johanjoensson/Komborobot/Dokumentation/Teknisk_Dokumentation/appendix.tex

%% --------------------------------------------------------------------------------------------------------------------------------------------
% APPENDIX - Blindtarm
%
% --matja307, 2012-05-06
%% --------------------------------------------------------------------------------------------------------------------------------------------

\appendix
\section{Appendix}

\lstset{inputencoding=utf8,
        language=c,
        linewidth=\textwidth,
        basicstyle=\scriptsize,
        numbers=left,
        stepnumber=1,
        tabsize=8,
        showtabs=false
}
\lstset{literate={å}{{\aa}}1
                {ä}{{\"a}}1
                {ö}{{\"o}}1
                {Å}{{\AA}}1
                {Ä}{{\"A}}1
                {Ö}{{\"O}}1
}

\subsection{Omvandlingsdiagram}
\label{appendix:cmomvandling}

\begin{figure}[H]
  \centering
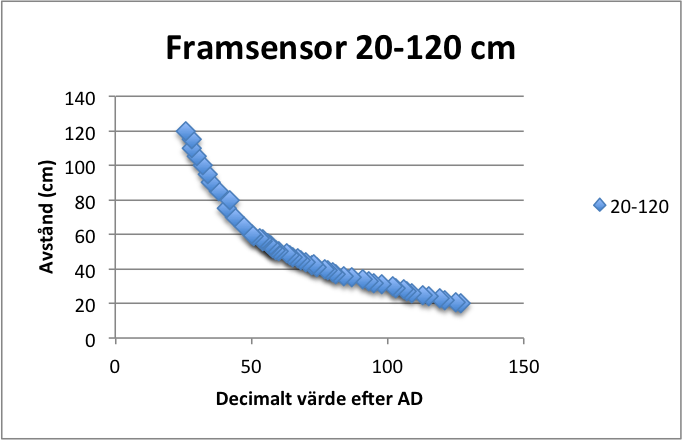
[picture p1: Dokumentation/Teknisk_Dokumentation/bilder/F_20_120.png]
 
  \caption{Framsensorn omvandling 20-120}
\end{figure}

\begin{figure}[H]
  \centering
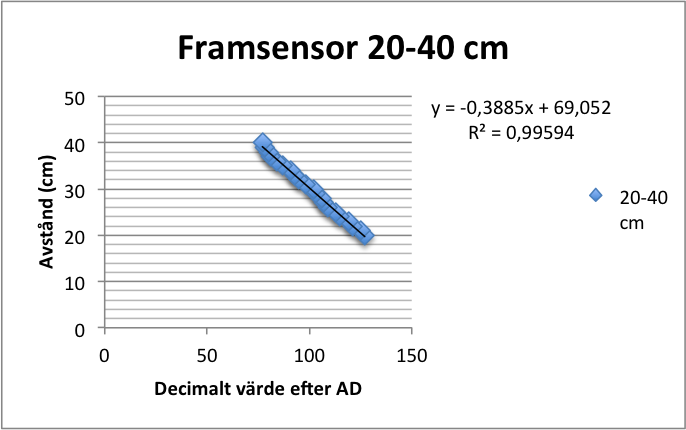
[picture p2: Dokumentation/Teknisk_Dokumentation/bilder/F_20_40.png]
 
  \caption{Framsensorn omvandling 20-40}
\end{figure}

\begin{figure}[H]
  \centering
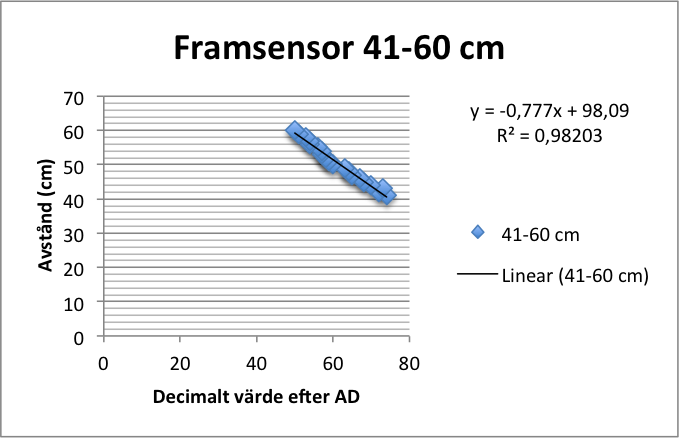
[picture p3: Dokumentation/Teknisk_Dokumentation/bilder/F_41_60.png]
 
  \caption{Framsensorns omvandling 41-60}
\end{figure}

\begin{figure}[H]
  \centering
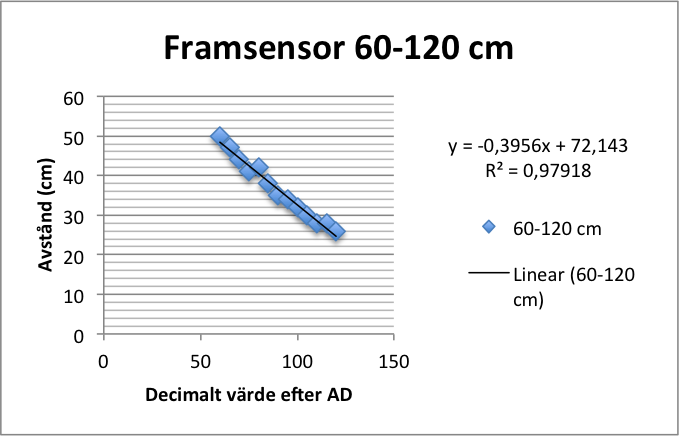
[picture p4: Dokumentation/Teknisk_Dokumentation/bilder/F_60_120.png]
 
  \caption{Framsensorn omvandling 60-120}
\end{figure}

\begin{figure}[H]
  \centering
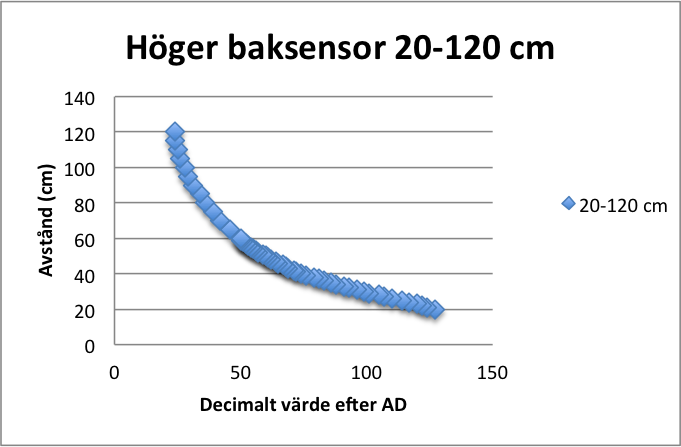
[picture p5: Dokumentation/Teknisk_Dokumentation/bilder/HB_20_120.png]
 
  \caption{Höger baksensor 20-120}
\end{figure}

\begin{figure}[H]
  \centering
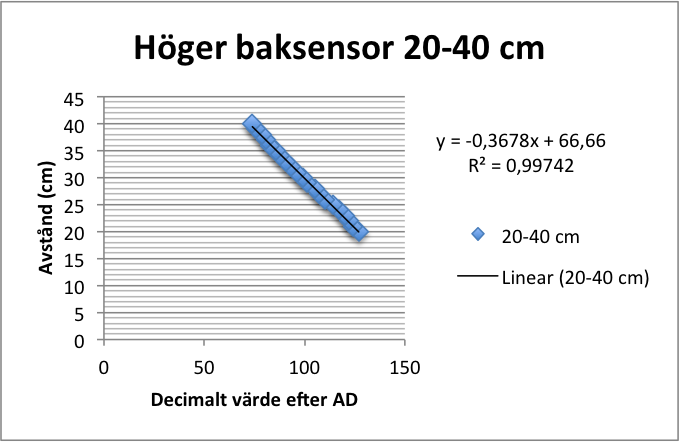
[picture p6: Dokumentation/Teknisk_Dokumentation/bilder/HB_20_40.png]
 
  \caption{Höger baksensor 20-40}
\end{figure}

\begin{figure}[H]
  \centering
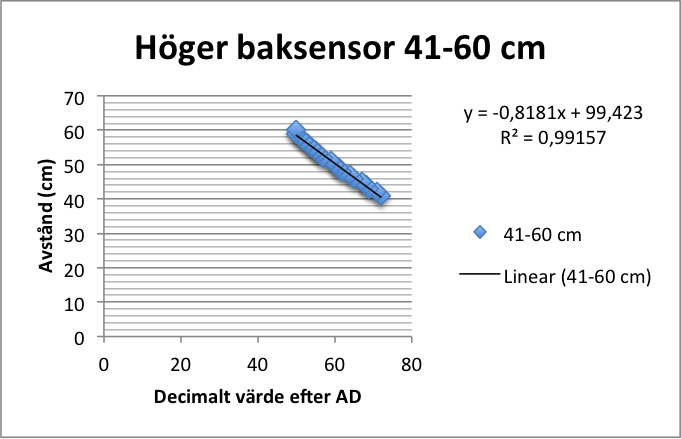
[picture p7: Dokumentation/Teknisk_Dokumentation/bilder/HB_41_60.png]
 
  \caption{Höger baksensor 41-60}
\end{figure}

\begin{figure}[H]
  \centering
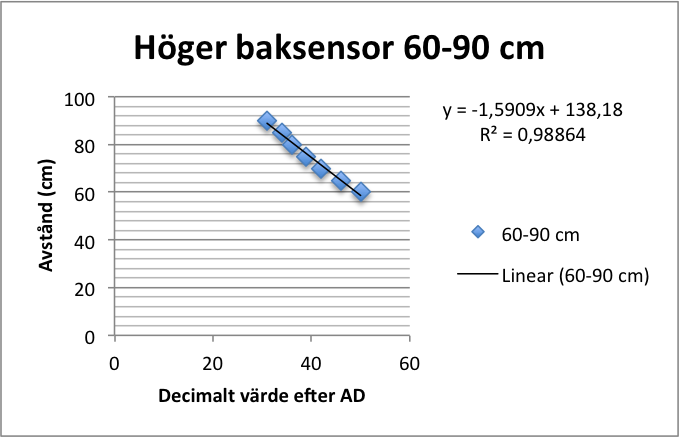
[picture p8: Dokumentation/Teknisk_Dokumentation/bilder/HB_60_90.png]
 
  \caption{Höger baksensor 60-90}
\end{figure}

\begin{figure}[H]
  \centering
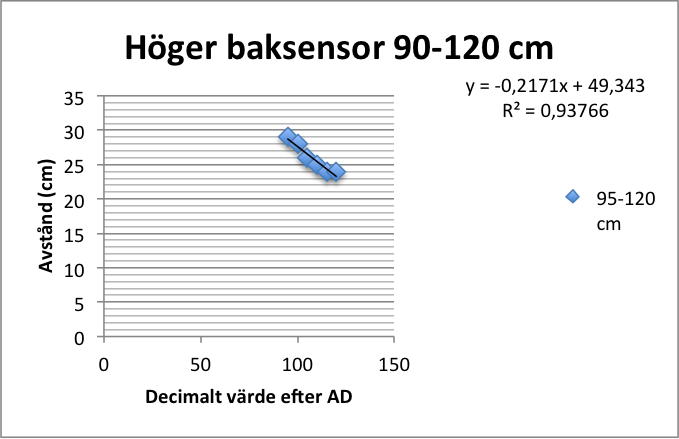
[picture p9: Dokumentation/Teknisk_Dokumentation/bilder/HB_90_120.png]
 
  \caption{Höger baksensor 90-120}
\end{figure}

\begin{figure}[H]
  \centering
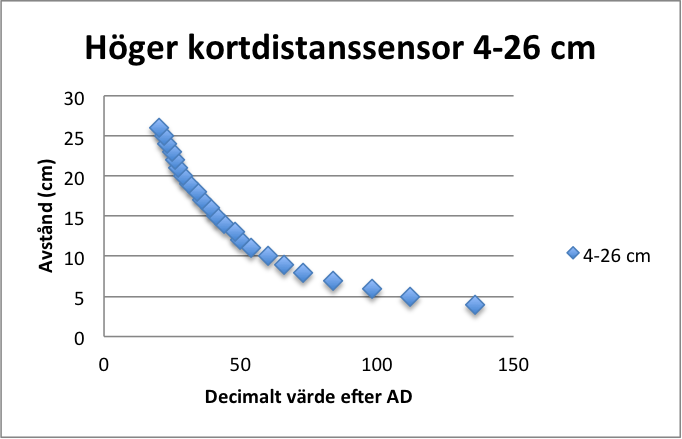
[picture p10: Dokumentation/Teknisk_Dokumentation/bilder/H_K_4_26.png]
 
  \caption{Höger kortdistanssensor 4-26}
\end{figure}

\begin{figure}[H]
  \centering
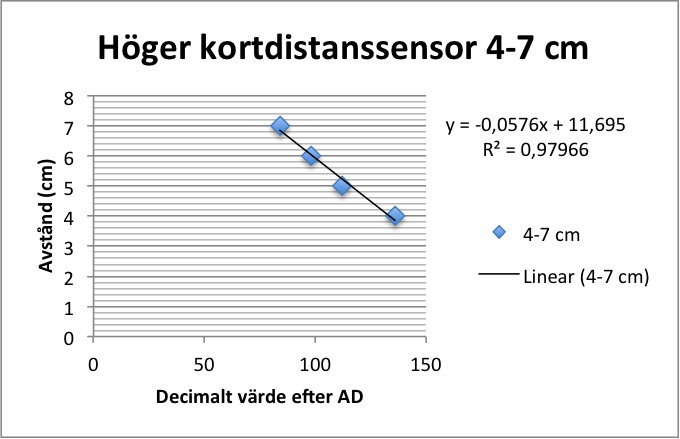
[picture p11: Dokumentation/Teknisk_Dokumentation/bilder/H_K_4_7png.png]
 
  \caption{Höger kortdistanssensor 4-7}
\end{figure}

\begin{figure}[H]
  \centering
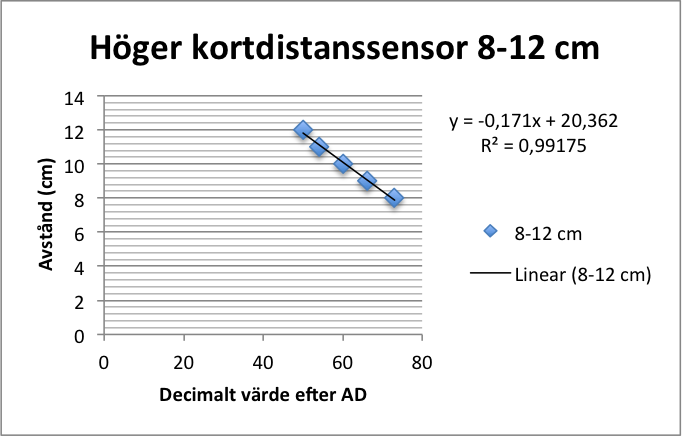
[picture p12: Dokumentation/Teknisk_Dokumentation/bilder/H_K_8_12.png]
 
  \caption{Höger kortdistanssensor 8-12}
\end{figure}

\begin{figure}[H]
  \centering
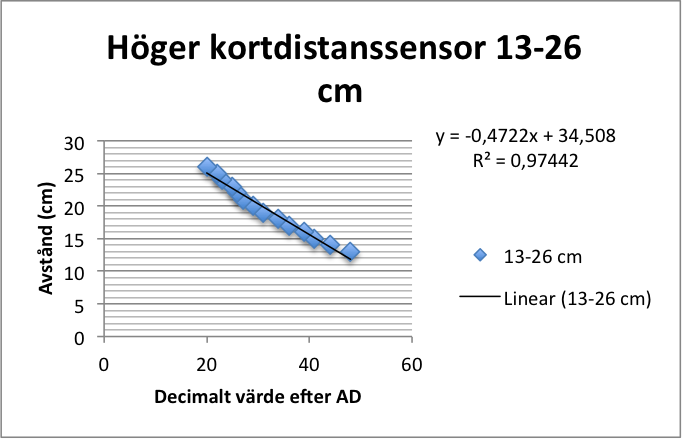
[picture p13: Dokumentation/Teknisk_Dokumentation/bilder/H_K_13_26.png]
 
  \caption{Höger kortdistanssensor 13-26}
\end{figure}

\begin{figure}[H]
  \centering
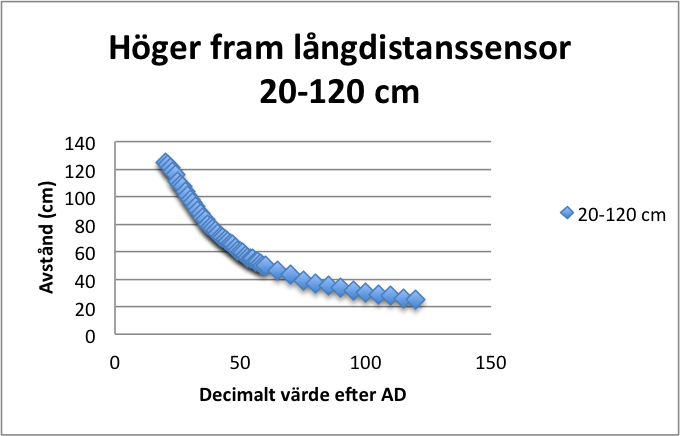
[picture p14: Dokumentation/Teknisk_Dokumentation/bilder/HF_20_120.png]
 
  \caption{Höger framsensor 20-120}
\end{figure}

\begin{figure}[H]
  \centering
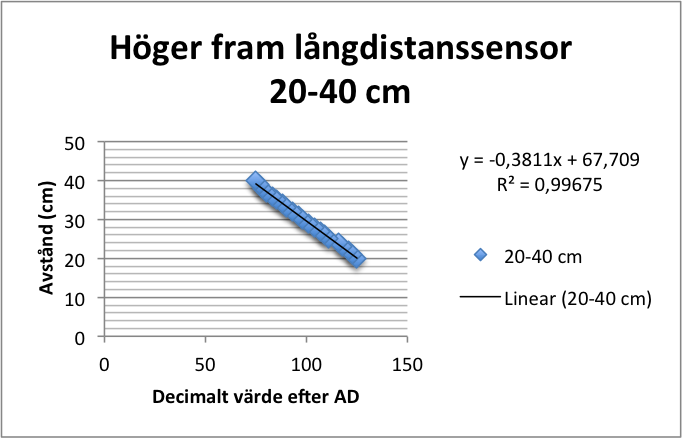
[picture p15: Dokumentation/Teknisk_Dokumentation/bilder/HF_20_40.png]
 
  \caption{Höger framsensor 20-40}
\end{figure}

\begin{figure}[H]
  \centering
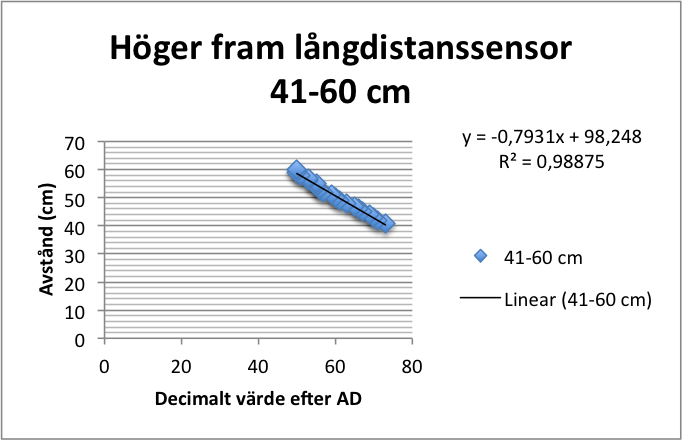
[picture p16: Dokumentation/Teknisk_Dokumentation/bilder/HF_41_60.png]
 
  \caption{Höger framsensor 41-60}
\end{figure}

\begin{figure}[H]
  \centering
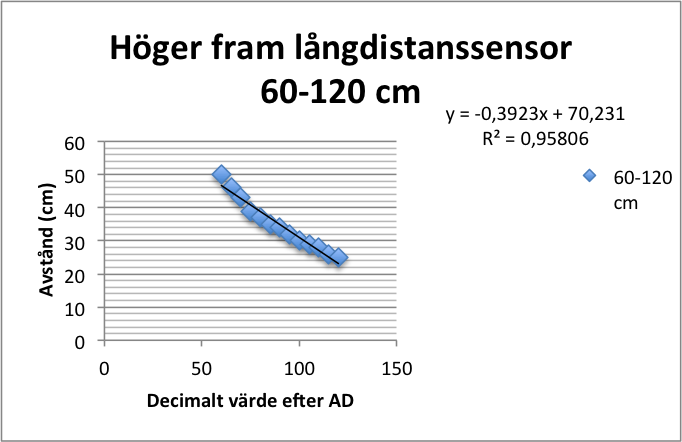
[picture p17: Dokumentation/Teknisk_Dokumentation/bilder/HF_60_120.png]
 
  \caption{Höger framsensor 60-120}
\end{figure}

\begin{figure}[H]
  \centering
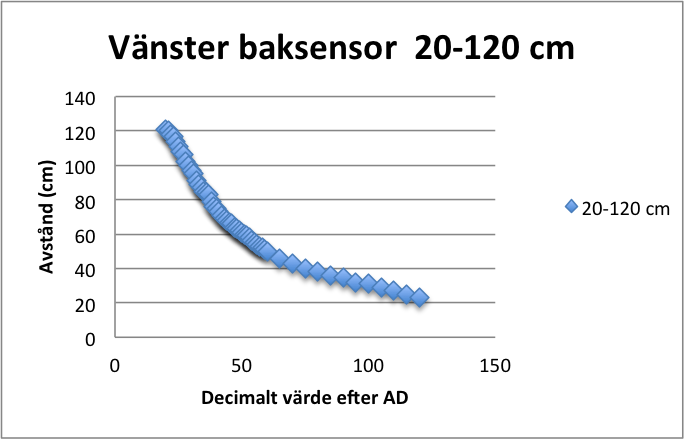
[picture p18: Dokumentation/Teknisk_Dokumentation/bilder/VB_20_120.png]
 
  \caption{Vänster baksensor 20-120}
\end{figure}

\begin{figure}[H]
  \centering
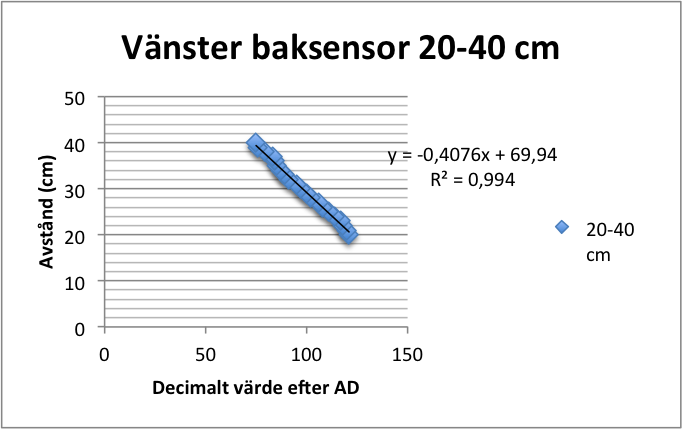
[picture p19: Dokumentation/Teknisk_Dokumentation/bilder/VB_20_40.png]
 
  \caption{Vänster baksensor 20-40}
\end{figure}

\begin{figure}[H]
  \centering
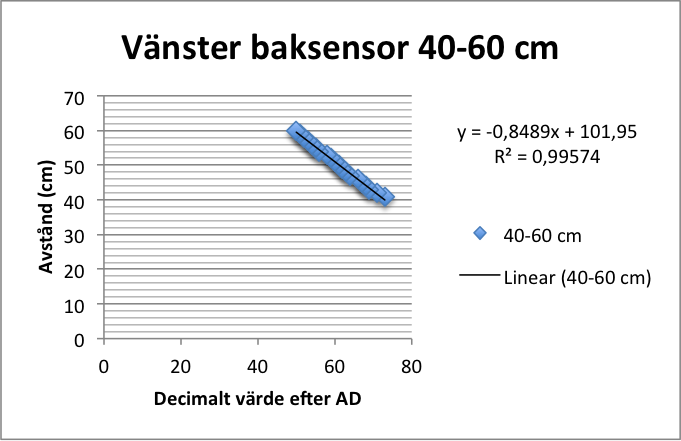
[picture p20: Dokumentation/Teknisk_Dokumentation/bilder/VB_40_60.png]
 
  \caption{Vänster baksensor 40-60}
\end{figure}

\begin{figure}[H]
  \centering
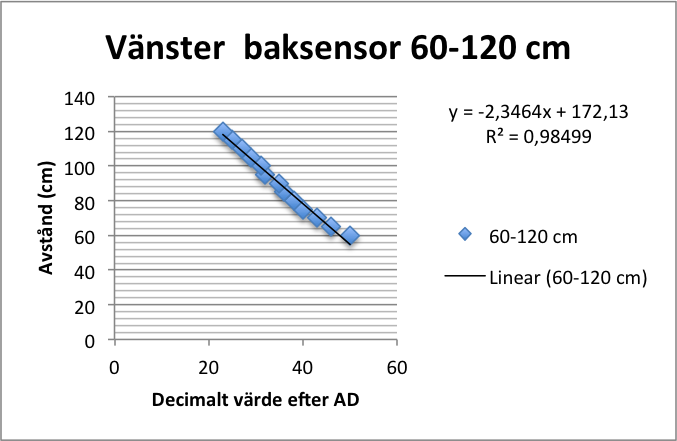
[picture p21: Dokumentation/Teknisk_Dokumentation/bilder/VB_60_120.png]
 
  \caption{Vänster baksensor 60-120}
\end{figure}

\begin{figure}[H]
  \centering
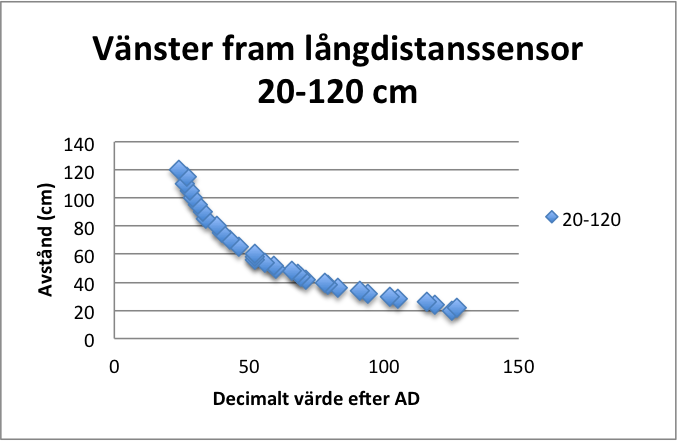
[picture p22: Dokumentation/Teknisk_Dokumentation/bilder/VF_20_120.png]
 
  \caption{Vänster framsensor 20-120}
\end{figure}

\begin{figure}[H]
  \centering
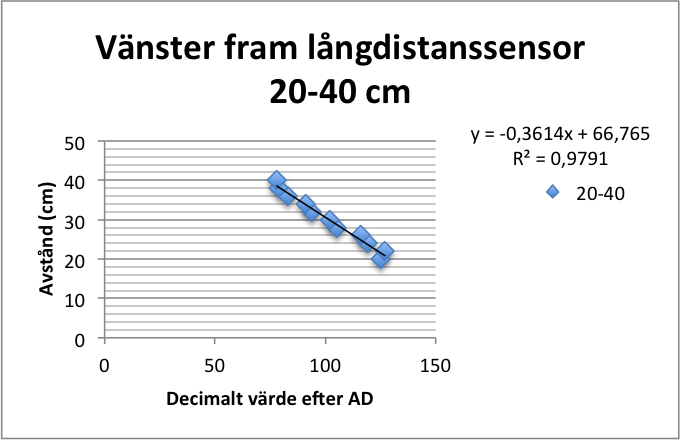
[picture p23: Dokumentation/Teknisk_Dokumentation/bilder/VF_20_40.png]
 
  \caption{Vänster framsensor 20-40}
\end{figure}

\begin{figure}[H]
  \centering
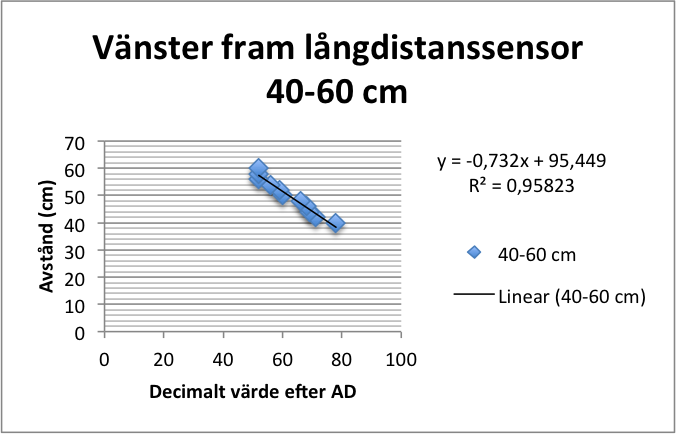
[picture p24: Dokumentation/Teknisk_Dokumentation/bilder/VF_40_60.png]
 
  \caption{Vänster framsensor 40-60}
\end{figure}

\begin{figure}[H]
  \centering
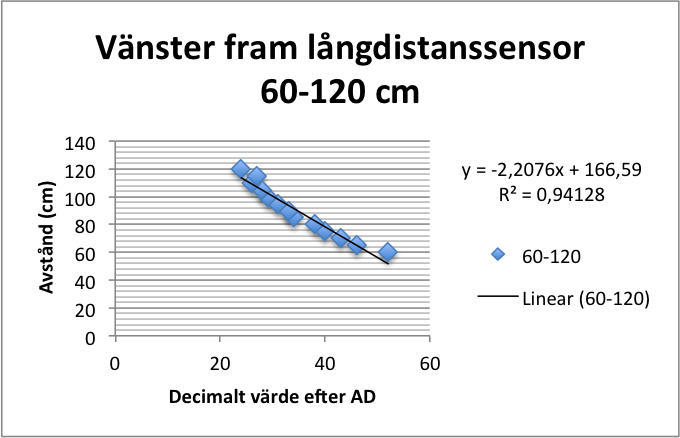
[picture p25: Dokumentation/Teknisk_Dokumentation/bilder/VF_60_120.png]
 
  \caption{Vänster framsensor 60-120}
\end{figure}

\subsection{Kod}
%\addcontentsline{toc}{subsection}{B \hspace*{1em} Kod}

%%%%%%%%%%%%%%%%%%%%%%%%%%%%%%%%%%%%%%%%%%%%%%%%%%%%%%%%%%%%%%%%%%%%%%%%%%%%%%%
% PC
% Kod till användargränssnittet
%%%%%%%%%%%%%%%%%%%%%%%%%%%%%%%%%%%%%%%%%%%%%%%%%%%%%%%%%%%%%%%%%%%%%%%%%%%%%%%
\subsubsection{PC}
\lstinputlisting[caption=input\_control,label=lst:input]{../../Kod/pc/input_control.c}
\lstinputlisting[caption=keypress.h,label=lst:keypress_h]{../../Kod/pc/keypress.h}
\lstinputlisting[caption=keypress.c,label=lst:keypress_c]{../../Kod/pc/keypress.c}
\lstinputlisting[caption=header.h,label=lst:header_h]{../../Kod/pc/header.h}
\lstinputlisting[caption=header.c,label=lst:header_c]{../../Kod/pc/header.c}
\lstinputlisting[caption=send\_receive.c,label=lst:sendrec_c]{../../Kod/pc/send_receive.c}
\lstinputlisting[caption=blue\_pc.h,label=lst:blue_h]{../../Kod/pc/blue_pc.h}
\lstinputlisting[caption=blue\_pc.c,label=lst:blue_c]{../../Kod/pc/blue_pc.c}
\lstinputlisting[caption=db.h,label=lst:db_h]{../../Kod/pc/db.h}
\lstinputlisting[caption=db.c,label=lst:db_c]{../../Kod/pc/db.c}
\lstinputlisting[caption=display.h,label=lst:display_h]{../../Kod/pc/display.h}
\lstinputlisting[caption=display.c,label=lst:display_c]{../../Kod/pc/display.c}

%%%%%%%%%%%%%%%%%%%%%%%%%%%%%%%%%%%%%%%%%%%%%%%%%%%%%%%%%%%%%%%%%%%%%%%%%%%%%%%
% Kommunikationsenhet
%%%%%%%%%%%%%%%%%%%%%%%%%%%%%%%%%%%%%%%%%%%%%%%%%%%%%%%%%%%%%%%%%%%%%%%%%%%%%%%
\newpage
\subsubsection{Kommunikationsenhet}
\lstinputlisting[caption=komm\_main.c,label=lst:komm_main_c]{../../Kod/komm/komm_main.c}
\lstinputlisting[caption=komm\_init.c,label=lst:komm_init_c]{../../Kod/komm/komm_init.c}
\lstinputlisting[caption=bluetooth\_interrupt.c,%
label=lst:bluetooth_interrupt_c]{../../Kod/komm/bluetooth_interrupt.c}
\lstinputlisting[caption=komm\_SPI.c,label=lst:komm_SPI_c]{../../Kod/komm/komm_SPI.c}

%%%%%%%%%%%%%%%%%%%%%%%%%%%%%%%%%%%%%%%%%%%%%%%%%%%%%%%%%%%%%%%%%%%%%%%%%%%%%%%
% Styrenehet
%%%%%%%%%%%%%%%%%%%%%%%%%%%%%%%%%%%%%%%%%%%%%%%%%%%%%%%%%%%%%%%%%%%%%%%%%%%%%%%
\newpage
\subsubsection{Styrenhet}
\lstinputlisting[caption=styr\_main.c,label=lst:styr_main_c]{../../Kod/styr/styr_main.c}
\lstinputlisting[caption=motor\_styrning.h,label=lst:motor_styrning_h]{../../Kod/styr/motor_styrning.h}
\lstinputlisting[caption=motor\_styrning.c,label=lst:motor_styrning_c]{../../Kod/styr/motor_styrning.c}
\lstinputlisting[caption=regulator.h,label=lst:regulator_h]{../../Kod/styr/regulator.h}
\lstinputlisting[caption=regulator.c,label=lst:regulator_c]{../../Kod/styr/regulator.c}
\lstinputlisting[caption=styr\_specialkommando.h,label=lst:styr_specialkommando_h]{../../Kod/styr/styr_specialkommando.h}
\lstinputlisting[caption=styr\_specialkommando.c,label=lst:styr_specialkommando_c]{../../Kod/styr/styr_specialkommando.c}
\lstinputlisting[caption=styr\_tolka\_data.h,label=lst:styr_tolka_data_h]{../../Kod/styr/styr_tolka_data.h}
\lstinputlisting[caption=styr\_tolka\_data.c,label=lst:styr_tolka_data_c]{../../Kod/styr/styr_tolka_data.c}
\lstinputlisting[caption=styr\_SPI.h,label=lst:styr_SPI_h]{../../Kod/styr/styr_SPI.h}
\lstinputlisting[caption=styr\_SPI.c,label=lst:styr_SPI_c]{../../Kod/styr/styr_SPI.c}

%%%%%%%%%%%%%%%%%%%%%%%%%%%%%%%%%%%%%%%%%%%%%%%%%%%%%%%%%%%%%%%%%%%%%%%%%%%%%%%
% Sensorenhet
%%%%%%%%%%%%%%%%%%%%%%%%%%%%%%%%%%%%%%%%%%%%%%%%%%%%%%%%%%%%%%%%%%%%%%%%%%%%%%%
\newpage
\subsubsection{Sensorenhet}
\lstinputlisting[caption=sensor.c,label=lst:sensor_c]{../../Kod/sensor/sensor.c}
\lstinputlisting[caption=sensor\_init.h,label=lst:sensor_init_h]{../../Kod/sensor/sensor_init.h}
\lstinputlisting[caption=sensor\_init.c,label=lst:sensor_init_c]{../../Kod/sensor/sensor_init.c}
\lstinputlisting[caption=sensor\_ad.h,label=lst:sensor_ad_h]{../../Kod/sensor/sensor_ad.h}
\lstinputlisting[caption=sensor\_ad.c,label=lst:sensor_ad_c]{../../Kod/sensor/sensor_ad.c}
\lstinputlisting[caption=sensorvarde\_omvandling.h,label=lst:sensorvarde_omvandling_h]{../../Kod/sensor/sensorvarde_omvandling.h}
\lstinputlisting[caption=sensorvarde\_omvandling.c,label=lst:sensorvarde_omvandling_c]{../../Kod/sensor/sensorvarde_omvandling.c}
\lstinputlisting[caption=displayenhet.h,label=lst:displayenhet_h]{../../Kod/sensor/displayenhet.h}
\lstinputlisting[caption=displayenhet.c,label=lst:displayenhet_c]{../../Kod/sensor/displayenhet.c}
\lstinputlisting[caption=linjeskillnad.h,label=lst:linjeskillnad_h]{../../Kod/sensor/linjeskillnad.h}
\lstinputlisting[caption=linjeskillnad.c,label=lst:linjeskillnad_c]{../../Kod/sensor/linjeskillnad.c}
\lstinputlisting[caption=upptack\_tejp.h,label=lst:upptack_tejp_h]{../../Kod/sensor/upptack_tejp.h}
\lstinputlisting[caption=upptack\_tejp.c,label=lst:upptack_tejp_c]{../../Kod/sensor/upptack_tejp.c}
\lstinputlisting[caption=special.h,label=lst:special_h]{../../Kod/sensor/special.h}
\lstinputlisting[caption=special.c,label=lst:special_c]{../../Kod/sensor/special.c}
\lstinputlisting[caption=sensor\_spi.h,label=lst:sensor_spi_h]{../../Kod/sensor/sensor_spi.h}
\lstinputlisting[caption=sensor\_spi.c,label=lst:sensor_spi_c]{../../Kod/sensor/sensor_spi.c}

\subsection{Kopplingsschema}
\begin{figure}[H]
 \centering
 
  \caption{Kopplingsschema för systemet}
\end{figure}

\subsection{Materiallista}
\input{material.tex}
