johanjoensson/Komborobot/Dokumentation/Teknisk_Dokumentation/other/appendix.tex

\newpage
\appendix

\lstset{language=c}
\lstset{linewidth=\textwidth}

\section{Kopplingsschema sensormodul}
\label{sensor-sch}
  \begin{figure}[ht!]
    \centering
      
      \begin{tabular}{| l | l |}
        \hline
        \textbf{Pin} & \textbf{Funktion} \\ \hline
        JP1.1 & 5 V drivspänning \\ \hline
        JP1.2 & Jord \\ \hline
        JP1.3 & 5 V för ADC:n \\ \hline
        JP1.4 & 5 V referensspänning \\ \hline
        JP1.5 & Klocka (Kristalloscilator) \\ \hline
        JP1.6 & Hård reset \\ \hline
        JP2.1 & Avståndssensor \\ \hline
        JP2.2 & Avståndssensor \\ \hline
        JP2.3 & Avståndssensor \\ \hline
        JP3.1 & Hjulsensor \\ \hline
        JP3.2 & Hjulsensor \\ \hline
        JP6.1 & Gyro \\ \hline
        JP8.1 & UART ut \\ \hline
        JP8.2 & UART in \\ \hline
      \end{tabular}
    \end{figure}

\newpage

\section{Kopplingsschema styrmodul}
\label{styr-sch}
  \begin{figure}[ht!]
    \centering
      
      \begin{tabular}{| l | l |}
        \hline
        \textbf{Pin} & \textbf{Funktion} \\ \hline
        JP1.1 & 5 V drivspänning \\ \hline
        JP1.2 & Klocka (Kristalloscilator) \\ \hline
        JP1.3 & 5 V för ADC:n \\ \hline
        JP1.4 & Jord \\ \hline
        JP1.5 & Hård reset \\ \hline
        JP2.1 & Drivhåll för motor \\ \hline
        JP2.2 & Drivhåll för motor \\ \hline
        JP3.1 & UART in \\ \hline
        JP3.2 & UART ut \\ \hline
        JP4.1 & PWM för motor \\ \hline
        JP4.2 & PWM för motor \\ \hline
      \end{tabular}
    \end{figure}
\section{Kod}
\subsection{PC}
\lstinputlisting[caption=input_control,label=lst:input]{../../Kod/pc/input_control.c}
\subsection{Kommunikationsenhet}
\subsection{Styrenhet}
\subsection{Sensorenhet}
