johanjoensson/Komborobot/Dokumentation/Kravspec_fungerande/delsystem2.pdf

Kommunikationsenhet

Styrenhet | Styrenhet
SPI Buss | PC Blåtand
