johanjoensson/Komborobot/Dokumentation/Kravspec/delsystem.pdf

## PC Styrenhet

Kommunikationsenhet

Sensorenhet
Buss

Blåtand
