johanjoensson/Komborobot/Dokumentation/Teknisk_Dokumentation/bilder/kopplingsschema.pdf

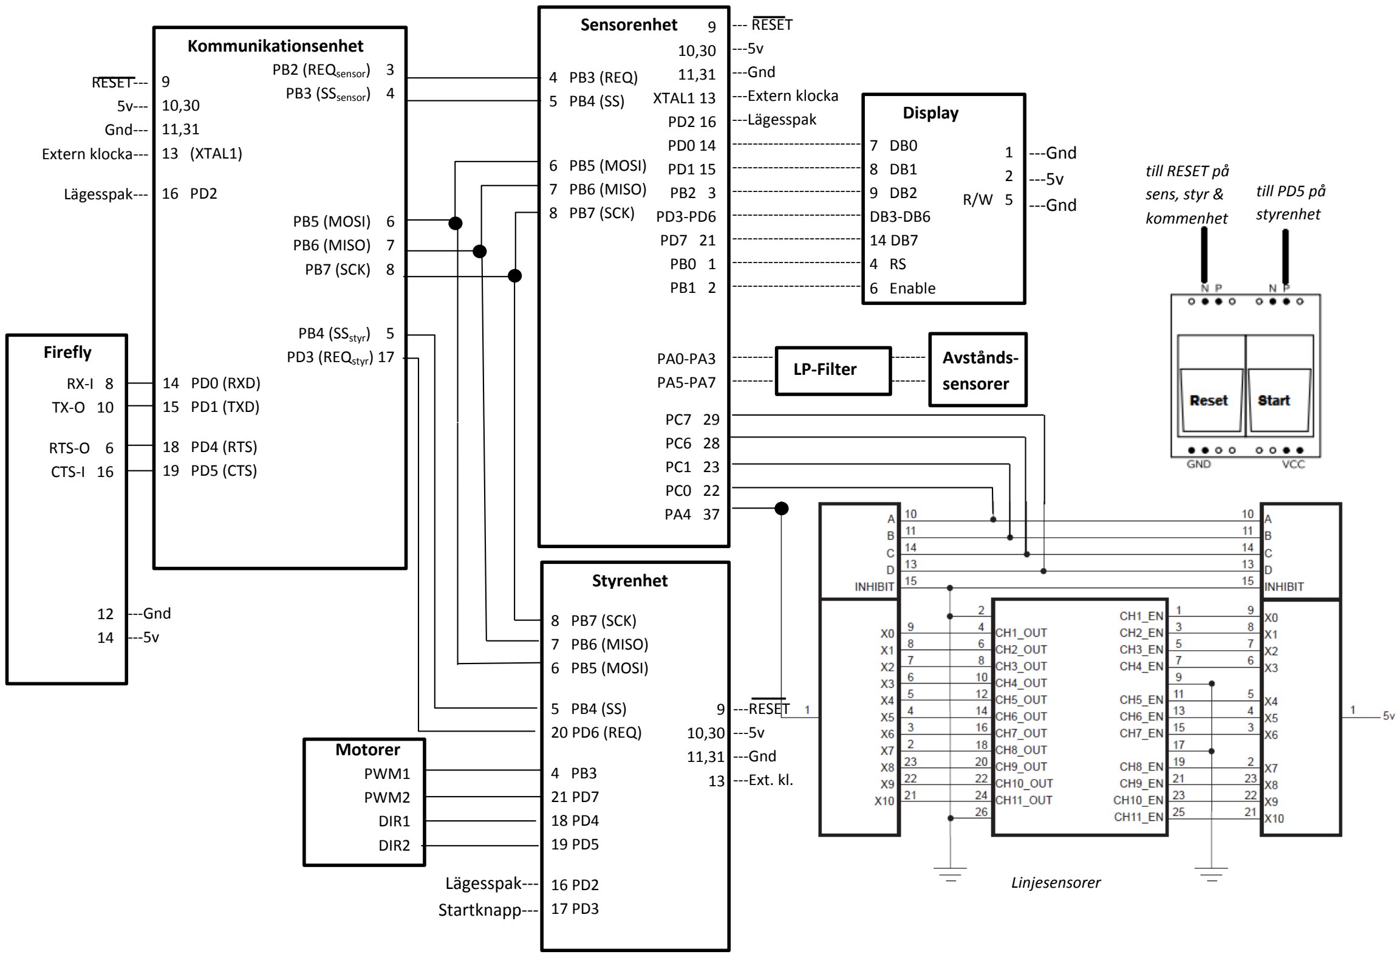
[picture p32: page 1]

Styrenhet

8 PB7 (SCK)
7 PB6 (MISO)
6 PB5 (MOSI)

5 PB4 (SS)
20 PD6 (REQ)

4 PB3
21 PD7
18 PD4
19 PD5

16 PD2
17 PD3

---RESET
---5v
---Gnd
---Ext. kl.

Kommunikationsenhet
PB2 (REQsensor) 3
PB3 (SSsensor) 4

PB5 (MOSI) 6
PB6 (MISO) 7
PB7 (SCK) 8

PB4 (SSstyr) 5
PD3 (REQstyr) 17
14 PD0 (RXD)
15 PD1 (TXD)

18 PD4 (RTS)
19 PD5 (CTS)

Firefly

RX-I 8
TX-O 10

RTS-O 6
CTS-I 16

12
14

9
10,30
11,31
13 (XTAL1)

16 PD2

9
10,30
11,31
XTAL1 13
PD2 16
PD0 14
PD1 15
PB2 3
PD3-PD6
PD7 21
PB0 1
PB1 2

PA0-PA3
PA5-PA7

Sensorenhet

4 PB3 (REQ)
5 PB4 (SS)

6 PB5 (MOSI)
7 PB6 (MISO)
8 PB7 (SCK)

9
10,30
11,31
13

RESET---
5v---
Gnd---
Extern klocka---

Lägesspak---

Linjesensorer

---Gnd
---5v

PC7 29
PC6 28
PC1 23
PC0 22
PA4 37

--- RESET
---5v
---Gnd
---Extern klocka
---Lägesspak

Motorer
PWM1
PWM2
DIR1
DIR2

7 DB0
8 DB1
9 DB2
DB3-DB6
14 DB7
4 RS
6 Enable

Display

1
2
R/W 5

---Gnd
---5v
---Gnd

Lägesspak---
Startknapp---
LP-Filter | Avstånds- sensorer

till RESET på
sens, styr &
kommenhet

till PD5 på
styrenhet
