johanjoensson/Komborobot/Dokumentation/Teknisk_Dokumentation/slutsats.tex

% !TEX encoding = UTF-8 Unicode

%% --------------------------------------------------------------------------------------------------------------------------------------------
% SLUTSATS - Möjliga förbättringar samt utvecklingsmöjligheter
%
% --matja307, 2012-05-06
%% --------------------------------------------------------------------------------------------------------------------------------------------
\section{Slutsats}
Roboten har designats så att den ska kunna vidareutvecklats och byggas på med fler enheter. Några sådana utvecklingsmöjligheter beskrivs nedan. 

\begin{enumerate}[i.]
\item En naturlig utvecklingsmöjlighet är att utöka informationen som visas på PCn. Ett exempel är att visa data även från linjesensorerna. 
Kommunikationsprotpkollet är sådant att det lätt kan utvidgas till att även innefatta denna dataöverföring från sensorenheten till PCn. 
\item Ett annat område som har utvecklingspotential är kalibreringen av linjesensorerna. Detta skulle lämpligen göras en gång för varje enskild sensor, utifrån 
uppmätt istället för inmatad data. 
\item Roboten har designats så att ytterligare funktionalitet vad gäller banans utformning kan läggas till. Exempel på förändringar är att ta bort behovet av riktningsmarkeringar i labyrintläge då de felaktiga vägarna är återvändsgränder av lämplig längd. 
\end{enumerate}
