johanjoensson/Komborobot/Dokumentation/Teknisk_Dokumentation/modulerna.tex

%% --------------------------------------------------------------------------------------------------------------------------------------------
% MODULERNA - Bara inkludering av dokument fšr modulerna.
%
% --matja307, 2012-05-06
%% --------------------------------------------------------------------------------------------------------------------------------------------

\input{komm.tex}
\input{pcmjuk.tex}
\input{sensor.tex}
\input{styr.tex}
