johanjoensson/Komborobot/Dokumentation/Banspecification/Labyrintanvisningar.pdf

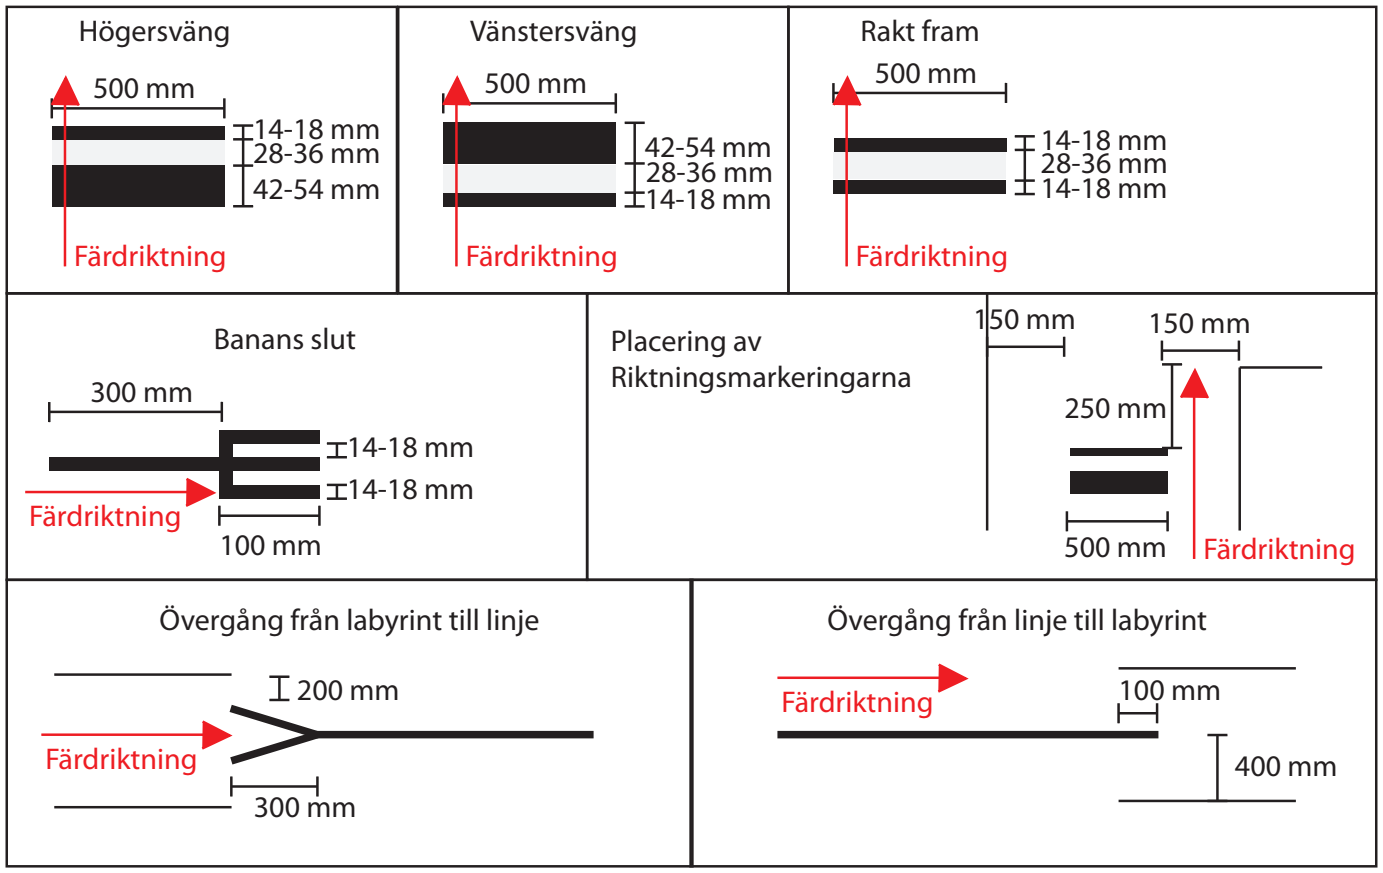
[picture p34: figure]
Högersväng; Banans slut; Färdriktning; Vänstersväng; Rakt fram; Placering av Riktningsmarkeringarna; Övergång från labyrint till linje; Övergång från linje till labyrint
