johanjoensson/Komborobot/Dokumentation/Projektplan/organisation-figur.pdf

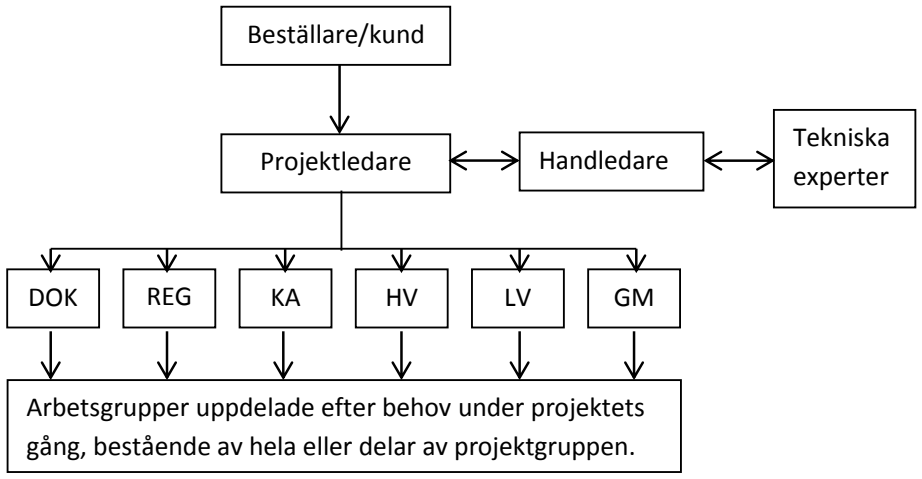
[picture p35: figure]
DOK; REG; Beställare/kund; Projektledare; Handledare; Tekniska experter

Arbetsgrupper uppdelade efter behov under projektets gång, bestående av hela eller delar av projektgruppen.
