johanjoensson/Komborobot/Dokumentation/Kravspec_fungerande/Oversikt.pdf

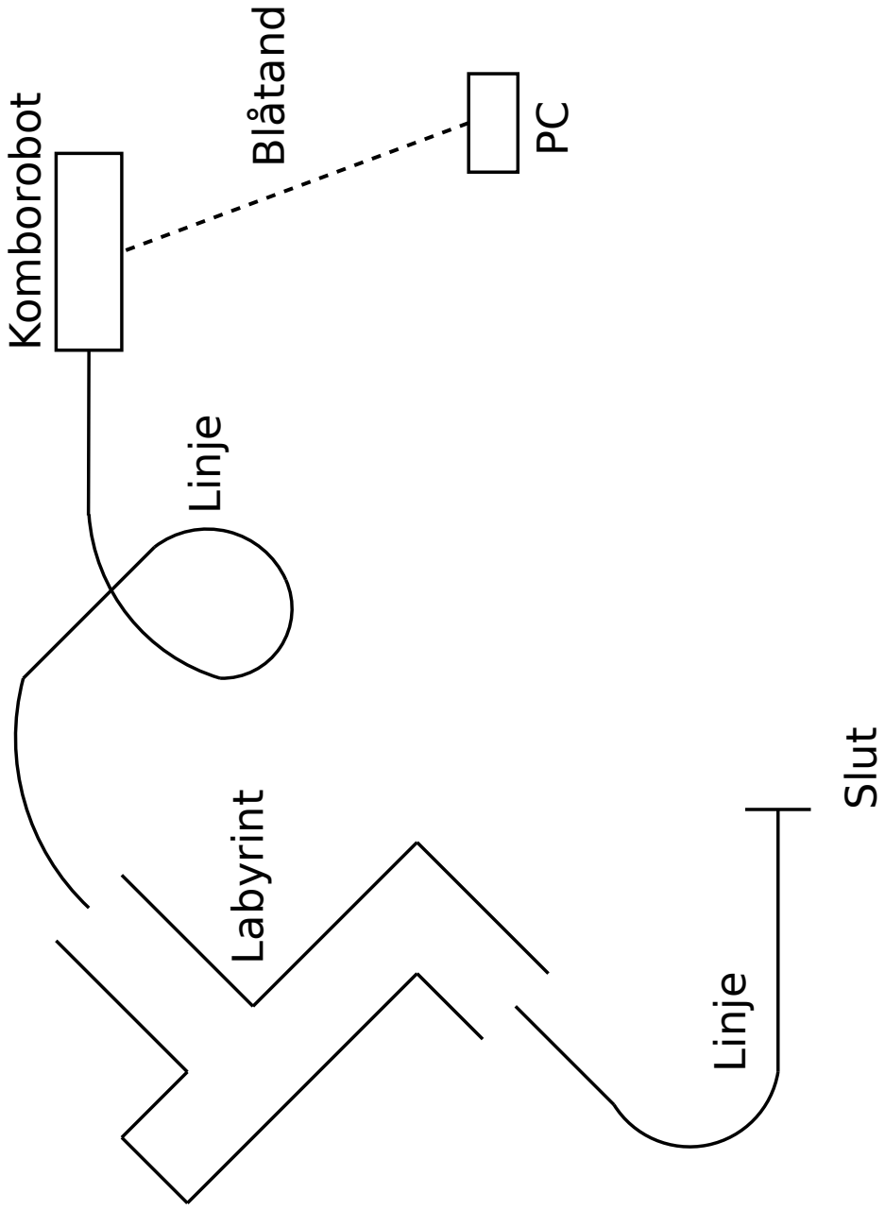
[picture p36: figure]
Komborobot; Labyrint; Linje; Slut; Blåtand
