johanjoensson/Komborobot/Dokumentation/Teknisk_Dokumentation/bilder/LPfilter.pdf

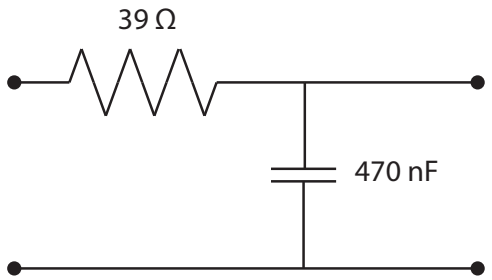
[picture p37: figure]
