johanjoensson/Komborobot/Dokumentation/Tekniskt_Dokumentation_old/styr.tex

\section{Styrenhet}
Styrenhetens uppgift är att styra motorerna utifrån data som skickas från kommunikationsenheten.
Styrenheten ska kunna vara i två lägen, autonomt läge då den reglerar motorerna utifrån sensorvärden eller 
fjärrstyrt läge då den tar emot och behandlar styrkommandon.
\subsection{Hårdvara}
Styrmodulen består av en AVR ATmega16 som ska placeras på robotplattformen.
Mikroprocessorns PWM-utgångar ska kopplas till PWM-ingångarna på robotplattformen för att styra motorerna.
För att styra riktning på motorerna kopplas två I/O-utgångar från mikroprocessorn till plattformens riktningsingångar.
Hur de olika pinnarna på processorn ska anslutas kan betraktas i figur \ref{fig:PINstyr}.

\begin{figure}[H]
  \centering
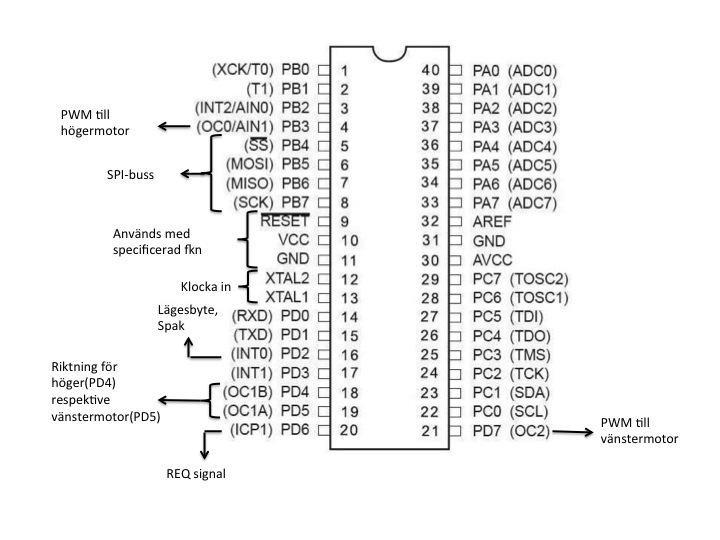
[picture p40: Dokumentation/Tekniskt_Dokumentation_old/bilder/PIN_styr.jpg]
 
  \caption{Styrsenhetens pin-anslutningar}
  \label{fig:PINstyr}
\end{figure}

\subsection{Mjukvara}
Mjukvaran kommer att fungera olika beroende på om roboten är i fjärrstyrt eller autonomt läge.
\subsubsection{Fjärrstyrt läge}
I fjärrstyrt läge så genereras ett avbrott när ett kommando tagits emot.
Varje kommando är en byte långt där de fyra mest signifikanta bitarna bestämmer vilket kommando som ska utföras
och de 4 minst signifikanta bitarna bestämmer hur kommandot ska utföras (t ex hur snabbt roboten ska svänga).
Uppdelningen kan ses i tabell \ref{tab:styrbitar}.

I avbrottsrutinen så tolkas kommandot och PWM-utgångarna. Därefter ställs I/O-utgångarna som styr riktningarna på motorerna. Om inget nytt avbrott kommer så fortsätter det senaste kommandot.
Kodningen av kommandon ses i tabell \ref{tab:styrkommando}.

\subsubsection{Autonomt läge}
I autonomt läge så ska styrenheten ta emot skillnaden mellan aktuella och önskade sensorvärden och styra motorerna utifrån detta.
För att undvika att roboten slingrar sig fram när den följer linjer eller 
väggar så kommer en PD-regulator att användas, se \ref{reglering}.
När data har tagits emot så genereras ett avbrott. 
I avbrottsrutinen kommer själva regleringen att ske. Den data som tas emot är en byte långt 
och tolkas som ett signat heltal. 

Utöver den vanliga regleringen ska fyra specialkommandon kunna hanteras:
\begin{itemize}
  \item{Sväng vänster 90\degree}
  \item{Sväng höger 90\degree}
  \item{Kör rakt fram}
  \item{Återuppta vanlig reglering}
\end{itemize}

Sväng vänster/höger 90\degree  kommer att utföras så att roboten kör fram en viss sträcka för att placera sig en bit in i kurvan (ca 40 cm). Därefter ska roboten svänga 90\degree  och fortsätta rakt fram tills specialkommandot ``Återuppta vanlig reglering'' mottas.
Specialkommandot ``Kör rakt fram'' resulterar i att roboten kör rakt fram tills specialkommandot ``Återuppta vanlig reglering'' mottas.
Kodningen av specialkommandon kan ses i tabell \ref{tab:special}.

\subsection{Reglering}
\label{reglering}
En PD-regulator kommer att användas för att undvika att roboten slingrar sig fram och för att ett litet stationärt fel inte kommer att störa
den autonoma styrningen mycket. I figur \ref{fig:regulator} ses ett blockschema på regulatorn där r är referenssignalen,
e är felet (skillnaden mellan aktuellt och önskat läge), u är insignalen (hur motorerna styrs) och y är utsignalen (robotens position).
Formeln för PD-reglering är: $$ u[n] = K_P*e[n] + K_D\frac{e[n]-e[n-1]}{\Delta T}$$
Där konstanterna $K_P$, $K_D$ och $\Delta T$ ska bestämmas. $K_P$ är konstanten som styr den proportionella delen (P) av regleringen, 
$K_D$ är konstanten som styr den deriverande delen (D) av regleringen och $\Delta T$ är tiden mellan två sensoravläsningar. 
För att bestämma konstanterna måste mätningar göras på sensorer, motorer och roboten.

\begin{figure}[H]
  \centering
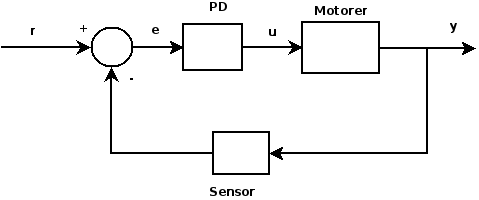
[picture p41: Dokumentation/Tekniskt_Dokumentation_old/bilder/regulator.png]
  
  \caption{Regulatorns blockschema}
  \label{fig:regulator}
\end{figure}
