johanjoensson/Komborobot/Dokumentation/Designspec/bilder/Pinspec, uppdaterad/Slide1.jpg

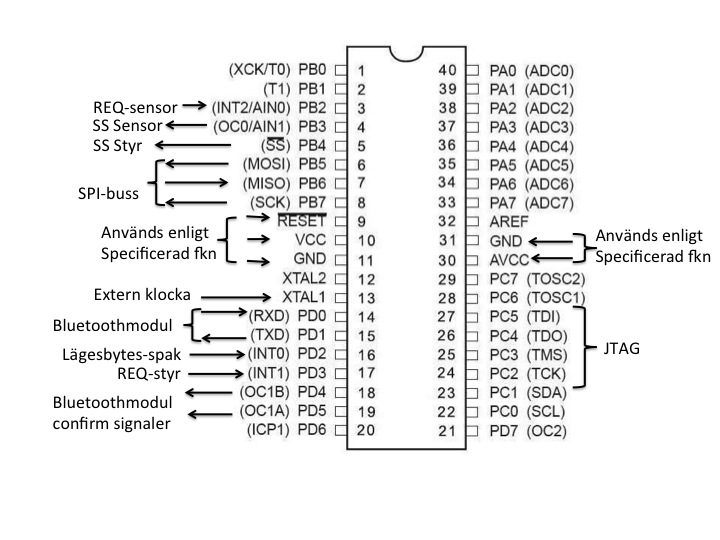
Dokumentation/Designspec/bilder/Pinspec, uppdaterad/Slide1.jpg
