johanjoensson/Komborobot/Dokumentation/kombo.jpg

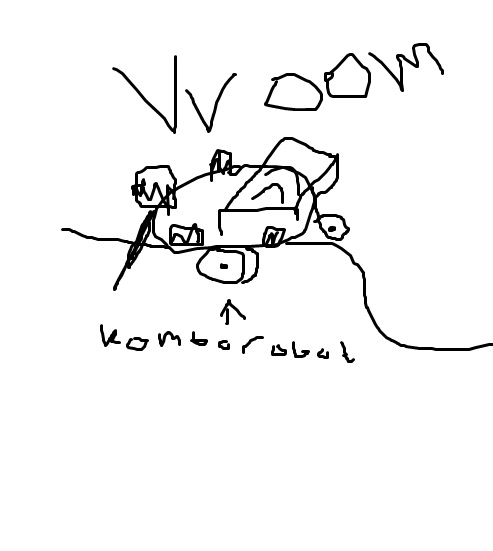
Dokumentation/kombo.jpg
