johanjoensson/Komborobot/Dokumentation/Teknisk_Dokumentation/bilder/bana2.jpg

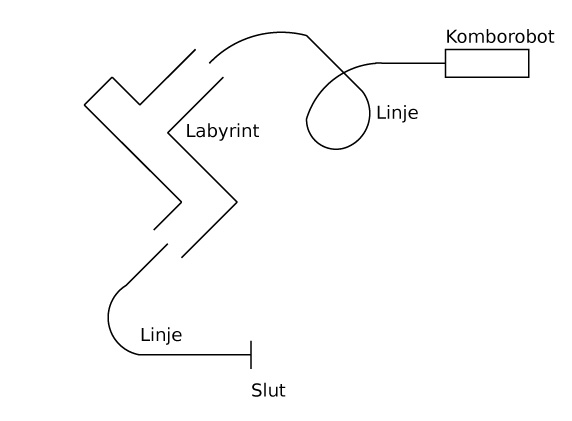
Dokumentation/Teknisk_Dokumentation/bilder/bana2.jpg
