johanjoensson/Komborobot/Dokumentation/Teknisk_Dokumentation/bilder/pinconf.jpg

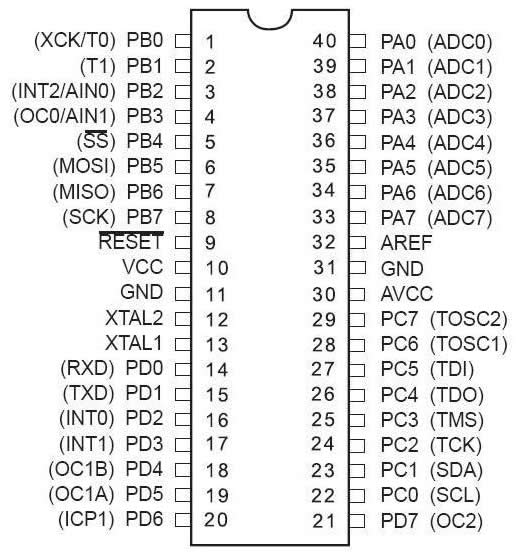
Dokumentation/Teknisk_Dokumentation/bilder/pinconf.jpg
