johanjoensson/Komborobot/Photo 2012-05-09 16 08 35.jpg

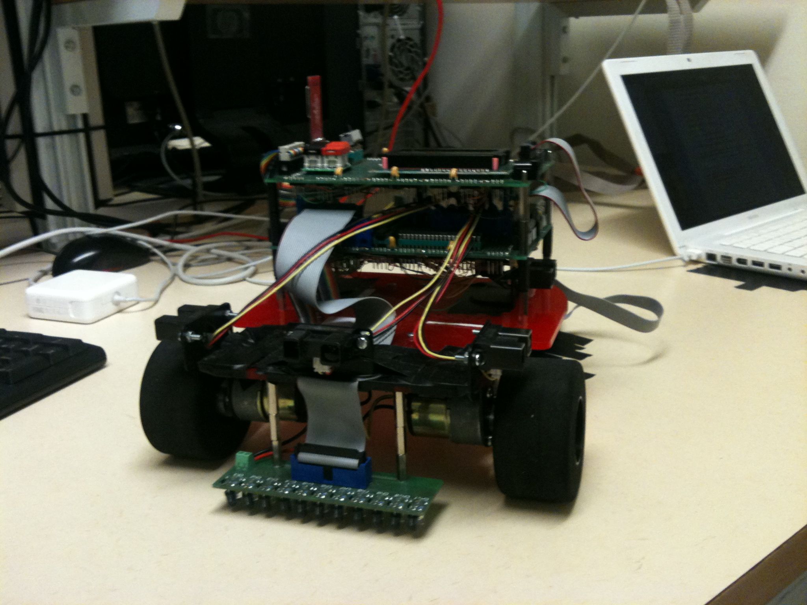
Photo 2012-05-09 16 08 35.jpg
