johanjoensson/Komborobot/Presentation/bana.png

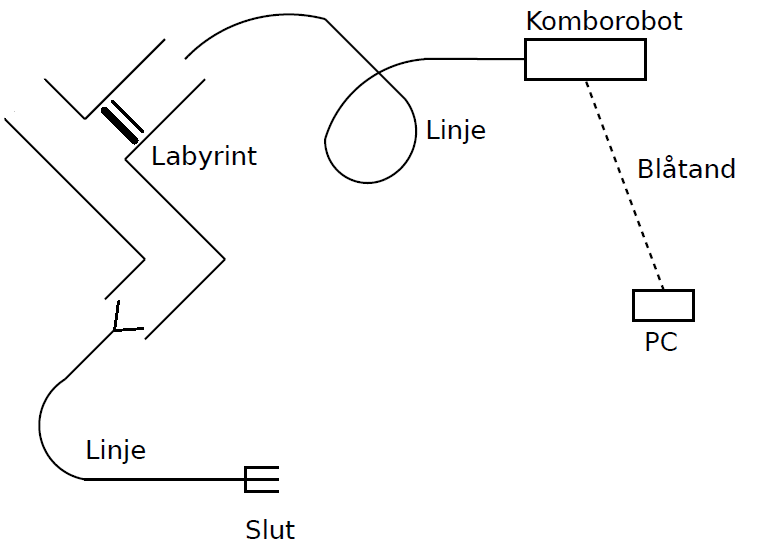
Presentation/bana.png
