johanjoensson/Komborobot/Presentation/bana_nivaa2.png

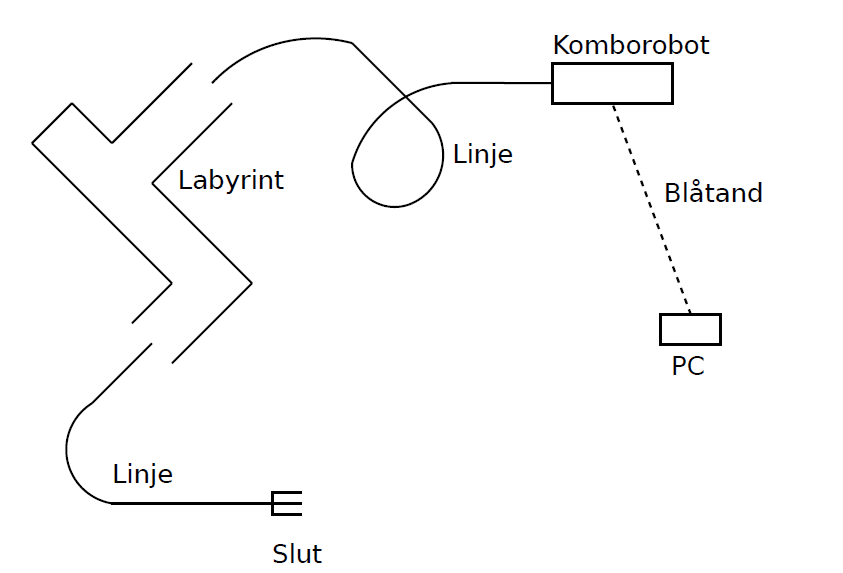
Presentation/bana_nivaa2.png
