johanjoensson/Komborobot/Presentation/bana_nivaa3.png

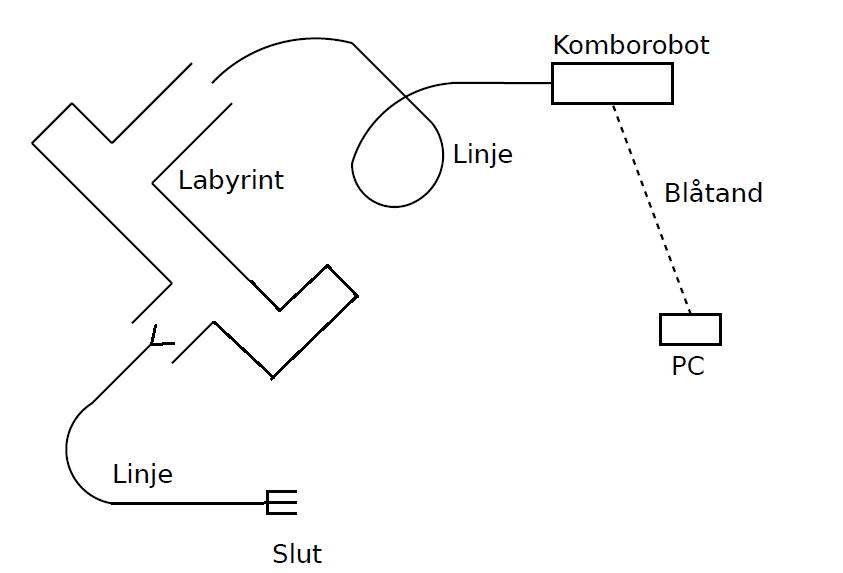
Presentation/bana_nivaa3.png
