johanjoensson/Komborobot/Dokumentation/Teknisk_Dokumentation/material.tex

% !TEX encoding = UTF-8 Unicode
%% --------------------------------------------------------------------------------------------------------------------------------------------
% MATERIAL.TEX
% Lista över material
%
% --matja307, 2012-05-15
%% --------------------------------------------------------------------------------------------------------------------------------------------

\begin{itemize}

\item 1 st - Bas av typ \emph{CarpetRover}
\item 2 st - Motorer av typ \emph{???}
\item 2 st - Virplattor med tillhörande fästanordning och kablage
\item 1 st - Batteri av typ \emph{???}
\item 3 st - AVR-processor av typ ATmega16
\item 1 st - EXO-3 kristalloscillator, 16 MHz
\item 1 st - LCD-Display av typ \emph{LCD JM162A}
\item 1 st - Skjutreglage
\item 1 st - Knappsats med två knappar
\item 1 st - Bluetooth-enhet av typ \emph{FireFly Bluetooth Modem - BlueSMiRF Gold}
\item 1 st - Linjesensormodul av typ \emph{4067}
\item 5 st - Avståndssensorer av typ \emph{GP2Y0A02YK}
\item 2 st - Avståndssensorer av typ \emph{???}

\end{itemize}

Förutom detta så krävs för fjärrstyrning en PC med operativsystem Linux och roboten tillhörande
programvara.
