johanjoensson/Komborobot/Dokumentation/Användarmanual/manual.tex

\documentclass[a4paper,12pt]{article}
\usepackage{graphicx}
\usepackage{epstopdf}
\usepackage{gensymb}
\usepackage{float}
\input{LIPS.tex}

\newcommand{\LIPSartaltermin}{2012/VT}
\newcommand{\LIPSkursnamn}{TSEA27}

\newcommand{\LIPSprojekttitel}{Komborobot}

\newcommand{\LIPSprojektgrupp}{Grupp 17}
\newcommand{\LIPSgruppepost}{komborobot@googlegroups.com}
\newcommand{\LIPSgrupphemsida}{finns ej}
\newcommand{\LIPSdokumentansvarig}{Mattias Jansson}

\newcommand{\LIPSkund}{ISY, Linköpings universitet, 581\,83 Linköping}
\newcommand{\LIPSkundkontakt}{Tomas Svensson, 013-281368, tomass@isy.liu.se}
\newcommand{\LIPSkursansvarig}{Tomas Svensson, 013-281368, tomass@isy.liu.se}
\newcommand{\LIPShandledare}{Olov Andersson, 013-282658, olov@isy.liu.se}

\newcommand{\LIPSdokumenttyp}{Användarmanual}
\newcommand{\LIPSredaktor}{Simon Larsson}
\newcommand{\LIPSversion}{1.0}
\newcommand{\LIPSdatum}{\dagensdatum}

\newcommand{\LIPSgranskare}{johjo939}
\newcommand{\LIPSgranskatdatum}{2012-05-10}
\newcommand{\LIPSgodkannare}{}
\newcommand{\LIPSgodkantdatum}{}

\begin{document}

\LIPStitelsida

%% Argument till \LIPSgruppmedlem: namn, roll i gruppen, telefonnummer, epost
\begin{LIPSprojektidentitet}
  \LIPSgruppmedlem{Simon Larsson}{Projektledare (PL)}{070-7311646}{simla804@student.liu.se}
  \LIPSgruppmedlem{\LIPSdokumentansvarig}{Dokumentansvarig (DOK)}{073-6837074}{matja307@student.liu.se}
  \LIPSgruppmedlem{Gustav Svensk}{Reglersystem (REG)}{073-6208776}{gussv666@student.liu.se}
  \LIPSgruppmedlem{Johan Jönsson}{Mjukvara (KA)}{073-8305758}{johjo939@student.liu.se}
  \LIPSgruppmedlem{Tobias Andersson}{Hårdvara (HV)}{073-7201098}{toban963@student.liu.se}
  \LIPSgruppmedlem{Markus Falck}{Leveransansvarig (LV)}{076-3457552}{marlo265@student.liu.se}
  \LIPSgruppmedlem{Simon Wallin}{Testansvarig (GM)}{076-2300665}{simwa252@student.liu.se}
\end{LIPSprojektidentitet}

\tableofcontents{}
\newpage

%% Argument till \LIPSversionsinfo: versionsnummer, datum, ändringar, utfört av, granskat av
\addcontentsline{toc}{section}{Dokumenthistorik}
\begin{LIPSdokumenthistorik} 
  \LIPSversionsinfo{0.1}{2012-05-06}{Första utkast}{matja307}{johjo939}
  \LIPSversionsinfo{1.0}{2012-05-10}{Slutgiltig version }{matja307}{johjo939}
\end{LIPSdokumenthistorik}
\newpage 

\input{inledning.tex} % #1
\input{oversikt.tex} % #2
\input{autonomt.tex} % #3
\input{fjarrstyrt.tex} % #4

\newpage
\appendix
\end{document} 

%%% Local Variables: 
%%% mode: latex
%%% TeX-master: t
%%% End:
