johanjoensson/Komborobot/Dokumentation/Användarmanual/inledning.tex

% !TEX encoding = UTF-8 Unicode

%% --------------------------------------------------------------------------------------------------------------------------------------------
% INLEDNING 
%
%
% --mj 20120506
%% --------------------------------------------------------------------------------------------------------------------------------------------

\section{Inledning}
Detta dokument har till syfte att ge en utförlig beskrivning av de olika funktionerna hos Komborobot, samt hur roboten används. Roboten har två huvudsakliga användningsfall, dels kan den styras manuellt med en PC, dels kan den köras autonomt. De båda fallen beskrivs i detta dokument under respektive rubrik. Vidare beskrivs även hur banan ska utformas för att roboten ska kunna navigera självständigt. 

För en detaljerad beskrivning av hur Komborobot är uppbyggd och programmerad hänvisas till dokumentet \emph{Teknisk Dokumentation}.
