johanjoensson/Komborobot/Dokumentation/Användarmanual/referenser.tex

%% --------------------------------------------------------------------------------------------------------------------------------------------
% REFERENSER - Referenser, helt enkelt
%
% --matja307, 2012-05-06
%% --------------------------------------------------------------------------------------------------------------------------------------------

\section{Referenser}

Todo: Referenslista.
