johanjoensson/Komborobot/Dokumentation/Användarmanual/bilder/tejpmarkeringar.pdf

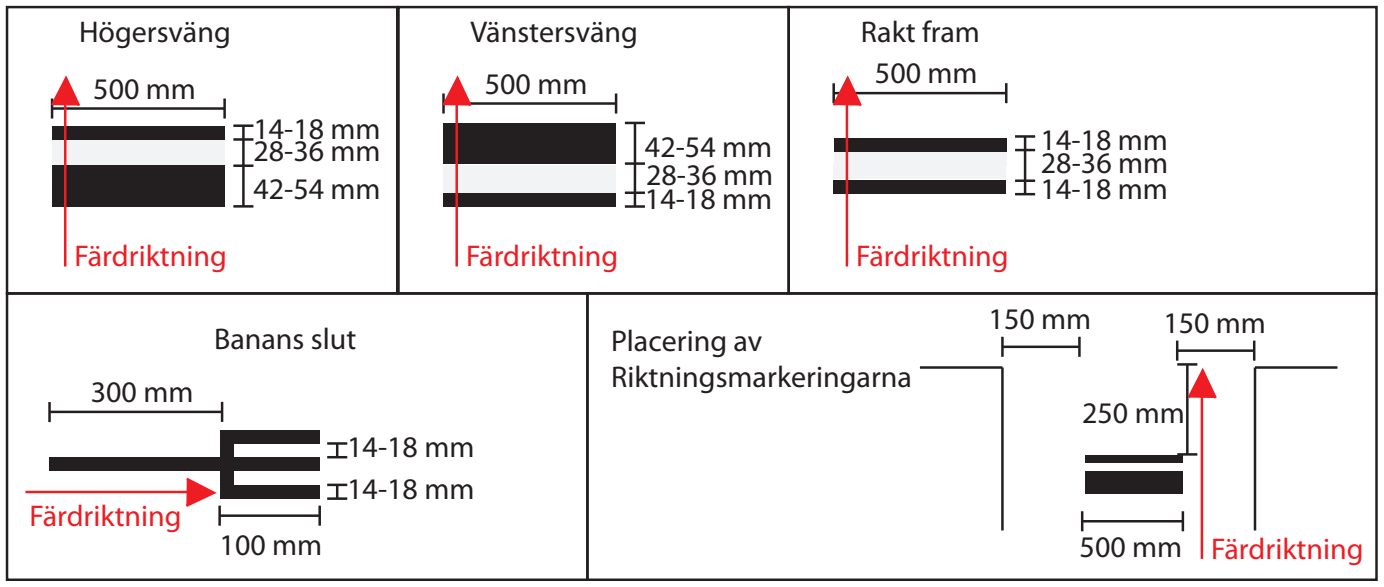
[picture p57: figure]
Högersväng; Banans slut; Färdriktning; Vänstersväng; Rakt fram; Placering av Riktningsmarkeringarna
