johanjoensson/Komborobot/Dokumentation/Användarmanual/bilder/bild.jpg

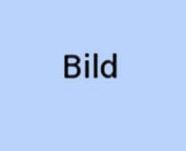
Dokumentation/Användarmanual/bilder/bild.jpg
