johanjoensson/Komborobot/Dokumentation/Användarmanual/bilder/display1.jpg

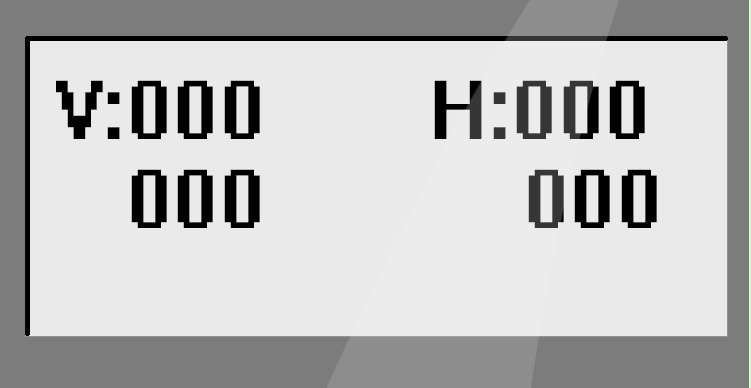
Dokumentation/Användarmanual/bilder/display1.jpg
