johanjoensson/Komborobot/Dokumentation/Användarmanual/bilder/display2.jpg

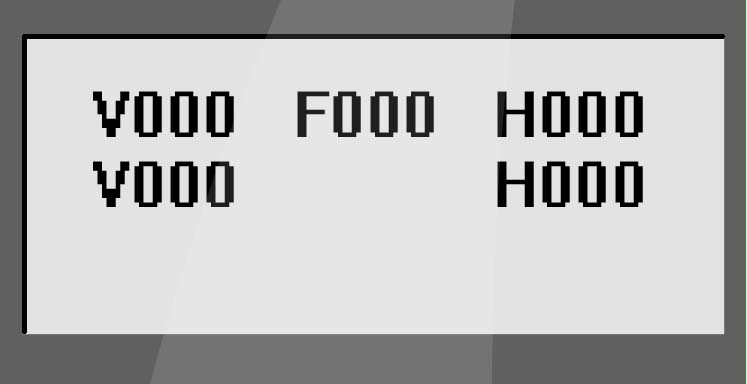
Dokumentation/Användarmanual/bilder/display2.jpg
