johanjoensson/Komborobot/Dokumentation/Användarmanual/bilder/produktbild.png

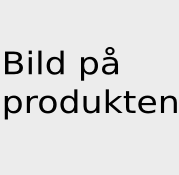
Dokumentation/Användarmanual/bilder/produktbild.png
