johanjoensson/Komborobot/Dokumentation/Användarmanual/bilder/robot1.jpg

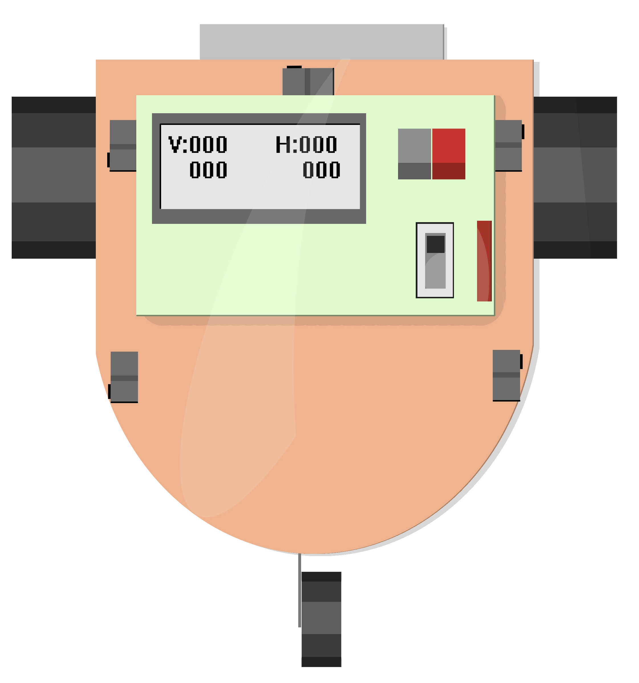
Dokumentation/Användarmanual/bilder/robot1.jpg
