johanjoensson/Komborobot/Dokumentation/Användarmanual/bilder/robot2.jpg

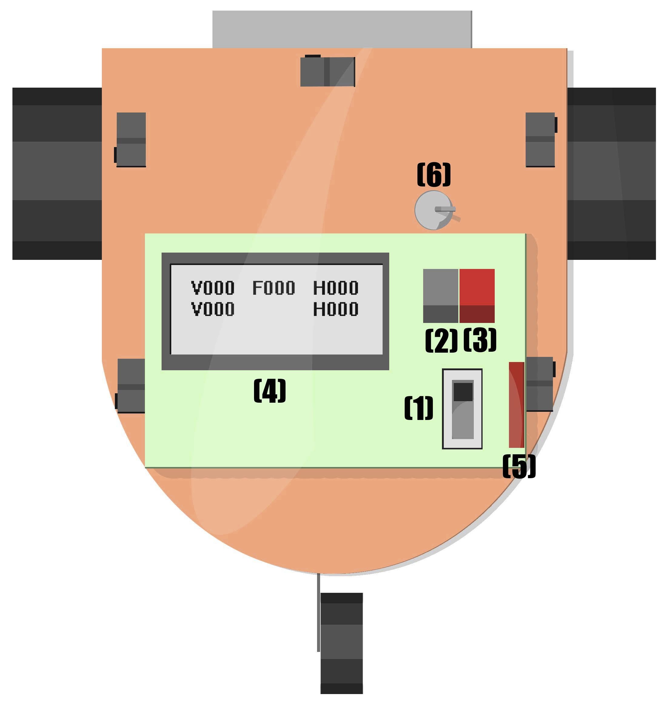
Dokumentation/Användarmanual/bilder/robot2.jpg
