johanjoensson/Komborobot/Dokumentation/Användarmanual/bilder/robot.gif

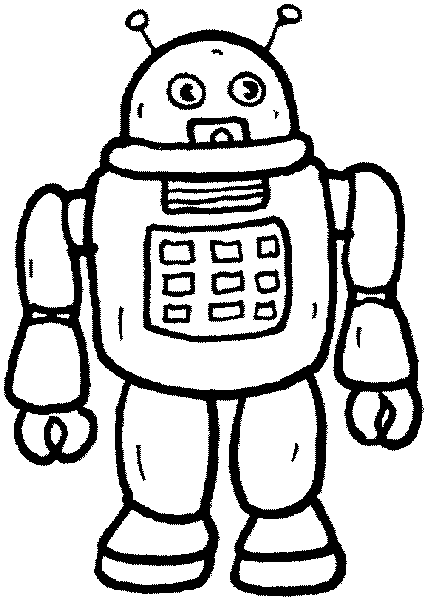
Dokumentation/Användarmanual/bilder/robot.gif
