johanjoensson/Komborobot/Dokumentation/Användarmanual/bilder/spak1.jpg

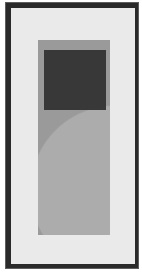
Dokumentation/Användarmanual/bilder/spak1.jpg
