johanjoensson/Komborobot/Dokumentation/Användarmanual/bilder/spak2.jpg

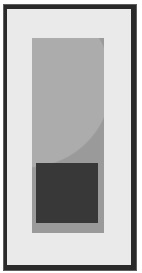
Dokumentation/Användarmanual/bilder/spak2.jpg
