johanjoensson/Komborobot/Dokumentation/Användarmanual/bilder/spakar2.jpg

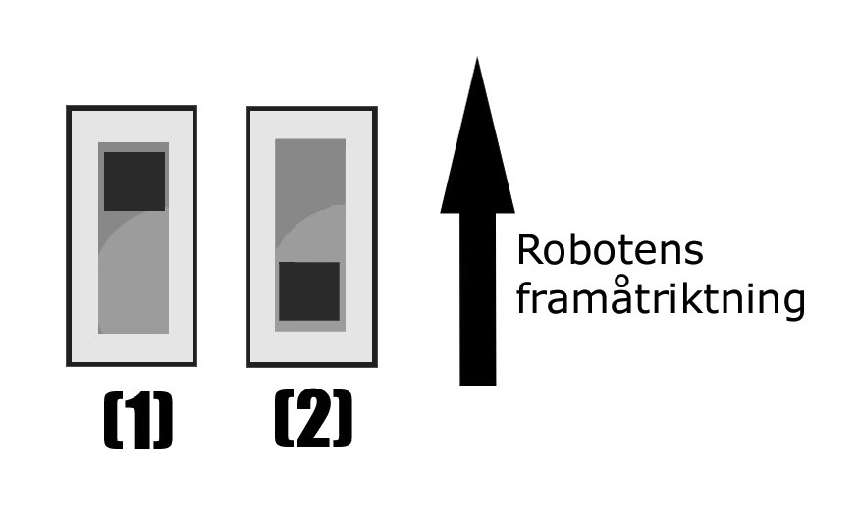
Dokumentation/Användarmanual/bilder/spakar2.jpg
