johanjoensson/Komborobot/Dokumentation/Användarmanual/bilder/spakar.png

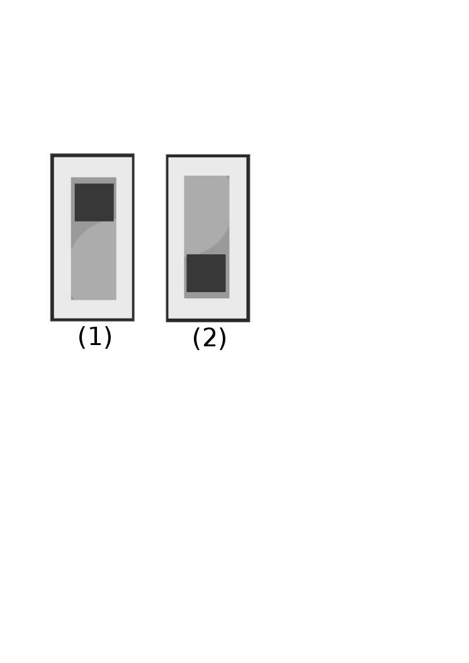
Dokumentation/Användarmanual/bilder/spakar.png
