johanjoensson/Komborobot/Dokumentation/Teknisk_Dokumentation/bilder/systemoversikt.pdf

# Sensorenhet

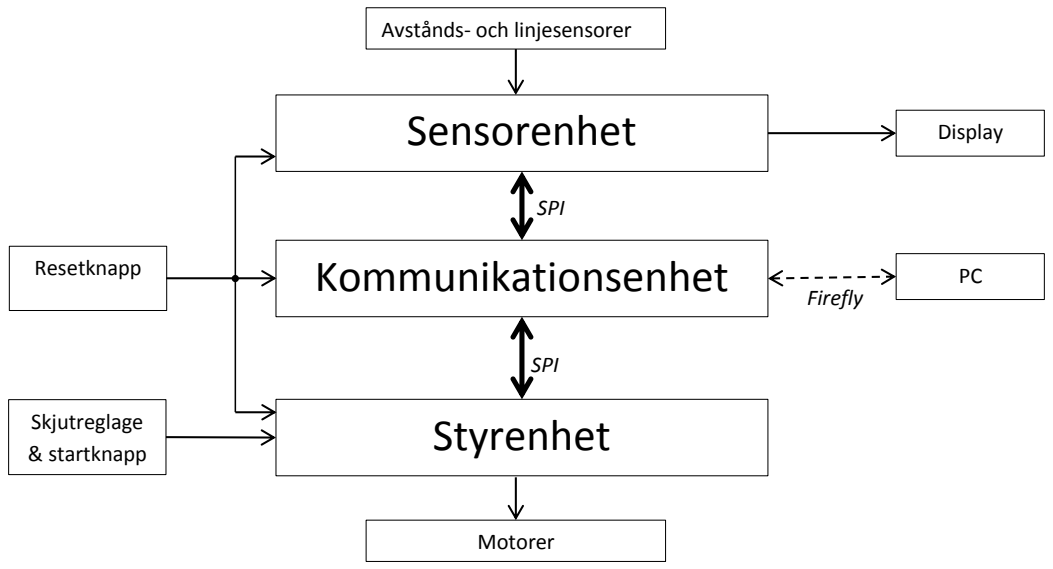
[picture p69: page 1]
Kommunikationsenhet; Styrenhet; Motorer; Display; Firefly; SPI; Skjutreglage & startknapp; Resetknapp

Avstånds- och linjesensorer
