johanjoensson/Komborobot/Dokumentation/Teknisk_Dokumentation/bilder/Uppkoppling_linjesensorer.pdf

# AVR

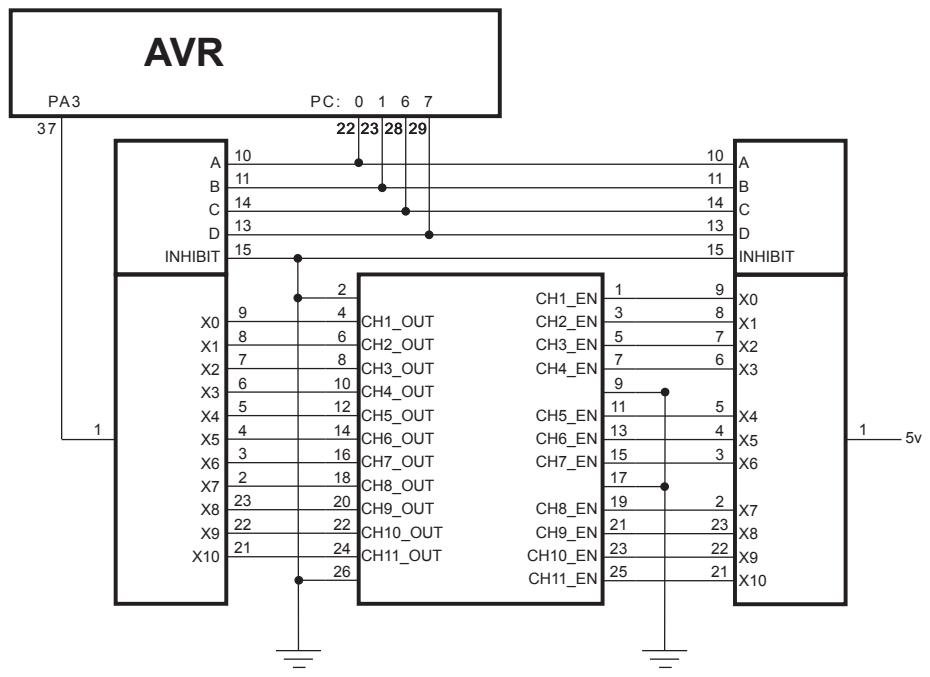
[picture p70: page 1]
CH1_OUT CH2_OUT CH3_OUT CH4_OUT CH5_OUT CH6_OUT CH7_OUT CH8_OUT CH9_OUT CH10_OUT CH11_OUT; ABCD; INHIBIT
