johanjoensson/Komborobot/Kod/sensor/sensorvarde_omvandling.h

/*
 *  sensorvarde_omvandling.h
 *  
 *
 *  Created by Markus Lothström on 2012-04-15.
 *  Copyright 2012 Umeå Universitet. All rights reserved.
 *
 */

#ifndef sensorvarde_omvandling_H
#define sensorvarde_omvandling_H

int hogeromvandling_front(int sensorvarde);
int hogeromvandling_back(int sensorvarde);
int vansteromvandling_front(int sensorvarde);
int vansteromvandling_back(int sensorvarde);
int framomvandling(int sensorvarde);
int kortvansteromvandling(int sensorvarde);
int korthogeromvandling(int sensorvarde);

#endif
