johanjoensson/Komborobot/Kod/styr/regulator.c

/*
 * =====================================================================================
 *
 *       Filename:  regulator.c
 *
 *    Description:  Ny PD-reglering sköts här minsann
 *
 *        Version:  1.0
 *        Created:  2012-03-27 19:29:43
 *       Revision:  none
 *       Compiler:  gcc
 *
 *         Author:  Gustav (), 
 *   Organization:  
 *
 * =====================================================================================
 */
#include <stdlib.h>
#include <stdio.h>
#include <avr/io.h>
#include <avr/interrupt.h>
#include "styr_spi.h"
#include "regulator.h"
#include "styr_specialkommando.h"

unsigned char speed = 105;
signed char old_distance_right = 0;
signed char old_distance_left = 0;
int old_line = 0;
int angle = 0;
int old_angle = 0;
int old_angle_count=0;
signed char old_value=0x00;
int rep_count = 0;
int WARNING=0;

signed char cut(signed char value, signed char max);


/*-----------------------------------------------------------------------------
 *  distance_regulator   
 *      input:  
 *              left_fron: avstånd till vänster (20 --- 120)
 *              right_front: avstånd till höger (20 --- 120)
 *              left_back: avstånd bak till vänster bak (10 --- 80)
 *              right_back: avstånd bak till vänster bak (10 --- 80)
 *      output: 
 *              värde som ska styra motorer (-70 --- 70)
 *-----------------------------------------------------------------------------*/
signed char distance_regulator(unsigned char left_front, unsigned char left_back,
                unsigned char right_front, unsigned char right_back,
				unsigned char short_left, unsigned char short_right)
{
		speed = 105;
        int Kp = 5;
		int Ka = 1;
        int Kd = 18;
		unsigned char crossing = 0;

        signed char outvalue=0;

        signed char difference_left = ((left_front - 1) - left_back);		
		signed char difference_right = (right_front) - right_back;	
		signed char difference_left_right_f = right_front - (left_front - 1);
		signed char difference_left_right_b = right_back - left_back;


		//reglera på nårmsta väggen
		if((right_front+right_back) < (left_front+left_back)){
				wall=0;
		}
		else {
				wall=1;
		}
		
		if(((left_front <= 20) && (left_back <= 20)) || left_front > 80){
				wall = 0;
		} else if(((right_front <= 20) && (right_back <= 20)) || right_front > 80){
				wall = 1;
		}

		if(left_front > 80 || right_front > 80 ){
				crossing = 1;
		} else {
				crossing = 0;
		}

		if(wall==0){	//höger vägg
				outvalue = -Kp*(difference_right);							// P-delen
				outvalue -= Kd*(difference_right - old_distance_right);    // D-delen
		}
		else if(wall==1){													//vänster vägg
				outvalue = Kp*(difference_left);               				// P-delen
				outvalue += Kd*(difference_left - old_distance_left);		// D-delen
		}
				
		old_distance_right = difference_right;
		old_distance_left = difference_left;		

		int temp =-Ka*(difference_left_right_f + difference_left_right_b)/(2);
		if((left_front <= 20) && (left_back <= 20)){
				outvalue -= 7;						
		}
		else if((right_front <= 20) && (right_back <= 20)){
				outvalue += 7;
		}
		else if(!crossing){
				outvalue += cut(temp,6);
		}

		if(short_right < 17){
				outvalue = 7;
		}
		else if(short_left < 17){
				outvalue = -7;
		}

        // sätter max- och minvärden på utvärdet
       	return cut(outvalue, 22);
}


/*-----------------------------------------------------------------------------
 *  line_regulator
 *  	input: 
 *	   	new_value värde att reglera på
 *  	output: 
 *              värde som ska styra motorer (-70 --- 70)
 *-----------------------------------------------------------------------------*/
signed char line_regulator(signed char new_value)
{
		speed = 110;
        signed char outvalue=0;
		int Kd=1;

        //Kollar om roboten rör sig åt höger eller vänster
        
		
		if(new_value==0 && abs(old_line)>90
		){
				if(old_line<0){
						angle=1;
				}
				else { 
						angle=-1;


				}
				outvalue=35;
				WARNING=1;
				}
		else if(new_value > old_line){
                angle = -1; // roboten går åt höger
				old_angle_count=0;
				WARNING=0;
        } 
		else if(new_value < old_line){
                angle = 1; // roboten går åt vänster
				old_angle_count=0;
				WARNING=0;
		}
		else if(new_value==old_line && old_angle_count<50){
				angle=old_angle;
				old_angle_count++;
				WARNING=0;
		}
		else if(new_value==old_line && old_angle_count>=50){ 
				outvalue=0;
			    angle=0;
			    WARNING=0;
		}
		
		if(rep_count<200){
				rep_count++;
				if(abs(new_value-old_value)>38){
						Kd=2;
						rep_count=199;
		
				}
				else {
						Kd=1;
			
				}
		}
		else {
				old_value=new_value;
				rep_count=0;
		}
	
			  
							
	
	if(angle==1 && WARNING==0){
				switch(new_value){
					
						case -127:
							outvalue = 40;
							break;
						
						case -90:
							outvalue = 36;
							break;
				
						case -75:
							outvalue = 33;
							break;

						case -50: 
							outvalue = 26;
							break;	
				
						case -25:
							outvalue = 22;
							break;
						case 0:
							outvalue = 19;
							break;
						case 25:
							outvalue = 17;
							break;
				
						case 50:
							outvalue = 14;
							break;
						
						case 75: 
							outvalue = 12;
							break;	
					
						case 90:
							outvalue = 10;
							break;
						
						case 127:
							outvalue = 9;
							break;
				
						default: 
							outvalue = 0;
							break;
				}
		}
		else if(angle==-1 && WARNING==0){
					
					switch(new_value){
						case -127:
							outvalue = 9;
							break;
						case -90:
							outvalue = 10;
							break;
						
						case -75:
							outvalue = 12;
							break;
						case -50: 
							outvalue = 12;
							break;	
					
						case -25:
							outvalue = 17;
							break;
						case 0:
                        	outvalue = 19;
							break;
						case 25:
							outvalue = 22;
							break;
							
						case 50:
							outvalue = 26;
							break;
						case 75: 
							outvalue = 33;
							break;	
							
						case 90:
							outvalue = 36;
							break;
						case 127:
							outvalue = 40;
							break;
						default: 
							outvalue = 0;
							break;
					}
	
		}
	
		if(!WARNING){
				old_line = new_value;
		}
	old_angle=angle;


        // sätter max- och minvärden på utvärdet

		return(outvalue*Kd);
}



/*-----------------------------------------------------------------------------
 *  drive_engines styr motorerna beroende på value
 *      input: 
 *              value, värde att reglera på
 *-----------------------------------------------------------------------------*/
void drive_engines(signed char value)
{
        if(value > 0){
                OCR2 = speed + 4 - value; // Vänstermotor
                OCR0 = speed; // + value; // Högermotor
        } else {
                value = -value;

                OCR2 = speed + 4; //+ value; // Vänstermotor
                OCR0 = speed - value; // Högermotor
        }
}

void drive_engines_line(signed char value)
{
        if(angle < 0){//Vänstersväng
				
			
					OCR2 = speed - (value+3);  // Vänstermotor
              		OCR0 = speed;			// Högermotor
					
                
        } else {// Högersväng


		
					OCR2 = speed+3;  // Vänstermotor
              		OCR0 = speed - value;// Högermotor
					
                
        }
}
/****************************************************************************\
	function: 	cut
	descr:		ser till att värden ligger i intervallet [-max,max]
\****************************************************************************/

signed char cut(signed char value, signed char max)
{
		if(value > max){
                value = max;
        } else if(value < -max){
                value = -max;
        }
		return value;
}
