johanjoensson/Komborobot/Kod/kod_som_orsakade_problem/komm/komm_main.c

#include <avr/io.h>
#include <avr/interrupt.h> 
int komm_init();
//SPI för Kruse (master)

void USARTInit(uint16_t ubrr_value);

volatile int a=0;

int main(){

		//volatile char SPIF;		//SPI interrupt flag
		

		
		
		komm_init();
		USARTInit(8);


		while (a<255) {
				a++;
				if (a>254) {
					a = 1;
				
				}
		}
		
				
		return 0;

	

//return 0;
}
