johanjoensson/Komborobot/Kod/sensor/upptack_tejp.c

#include <avr/io.h>
#include <avr/interrupt.h>
#include "upptack_tejp.h"
#include "sensor_ad.h"
#include "sensor_spi.h"
#include "linjeskillnad.h"

#define DELTA 10

/* 
 * ===  FUNCTION  ======================================================================
 *         Name:  Markning
 *  Description:  Tar emot nuvarande värde på mittensensorn
 *	Input:    Nuvarande värde på någon av de mittre sensorerna,
 *	1 för tejp 0 annars
 *	Output:	1 om markering för högersväng upptäckts, 2 om vänstersväng upptäckts,
 *	        3 om rakt fram upptäckts, 0 annars
 * =====================================================================================
 */
int count_2;
int time1;
int time2;
int iterations;
int counter;
int maze_mode_exit_cnt=0;
int line_fault_avoid_cnt_b=0;
int line_fault_avoid_cnt_w=0;

int find_ones(unsigned char array)
{
        if((array & 0x70) == 0x70){
                return 1;
        }
        else {
                return 0;
        }

}

int markning(int now_value){


        //Om är på Tejp, öka antalet iterationer
        if(now_value==1){
                line_fault_avoid_cnt_b++;
				line_fault_avoid_cnt_w=0;
				if(line_fault_avoid_cnt_b>=4){
						iterations++;
				}

        }	//Spara antalet iterationer när går av första markeringen
        else if(iterations > 0 && now_value==0 && count_2==0){
				line_fault_avoid_cnt_b=0;
				line_fault_avoid_cnt_w++;
				if(line_fault_avoid_cnt_w>=4){
						time1 = iterations;
        		        iterations=0;
                		count_2++;
				}


        }	//När går från tejp till ingen tejp, slå av timer 
                //och spara värde i time2
        else if(iterations > 0 && now_value==0 && count_2==1){
                
				time2 = iterations;
                iterations=0;
                count_2=0;
                counter=0;


                if(time1-time2>DELTA){
                        //Sväng höger
                        return 1;

                }
                else if(time2-time1>DELTA){
                        //Sväng vänster
                        return 2;


                }
                else{
                        //Kör rakt fram
                        return 3;

                }

        } 

        else {
                if(count_2){
                        counter++;
                }
                if(counter>200){
                        iterations=0;
                        count_2=0;
                        counter=0;
                }


				line_fault_avoid_cnt_b=0;
                return 0;
        }

        return 0;
}

/******************************************************************************
  Sätter maze_mode=1 om roboten har väggar på båda sidor och ingen tejp, annars
  sätts maze_mode=0 om det finns en linje och bara en vägg
*******************************************************************************/

void decide_maze_mode(int no_tape)
{
        if(maze_mode==0){
                if((no_tape==1) && (dist_left_front < 55) &&//
                                (dist_right_front < 55)) {
                        maze_mode=1;
                }
        }
        else {
                if((no_tape==0) && ((dist_left_front > 55) ||//
                                        (dist_right_front > 55))) {
                        if(maze_mode_exit_cnt==5){
                                maze_mode=0;
                                maze_mode_exit_cnt=0;
                        }
                        else {
                                maze_mode_exit_cnt++;
                        }
                }
                else {
                        maze_mode_exit_cnt=0;
                }
        }
}
