johanjoensson/Komborobot/Kod/styr/styr_SPI.c

#include <avr/io.h>
#include <avr/interrupt.h> 
#include "styr_spi.h"
#include "styr_tolka_data.h"
#include "motor_styrning.h"


ISR(SPI_STC_vect) //sensor REQ
{
		

	
				PORTD &= ~(1<<PD6); 	//REQ low
				header=SPDR;		//spara mottagen header
				SPDR=data;			//V?lj data f?r n?sta ?verf?ring
				PORTD |= (1<<PD6); 	//REQ high
				
				while(!(SPSR & (1<<SPIF))){
				;
				}
				PORTD &= ~(1<<PD6); 	//REQ low
				
				data=SPDR;			//spara mottagen data
				SPDR=0x00;
			
			
				tolka_data();

}

ISR(INT0_vect)
{
		decide_mode();
}


ISR(INT1_vect)
{
				start=1;
}


void req_sending()
{
		SPDR= header;
		PORTD |= (1<<PD6); //skicka req
}


void decide_mode()
{
		if(0x04==(PIND & 0x04)){
				auto_mode=1;
				stop(0x00);

		}
		else if(0x00==(PIND & 0x04)){
				auto_mode=0;
				stop(0x00);
		}
}
