johanjoensson/Komborobot/(commit log)

2012-01-27 Fixade fel i kravspecen och ändrade modul till enhet så det ska bli lite mer konsekvent, la till gensympaket, för \degree användes i kravspecen
2012-01-30 la till andra utkastet
2012-01-31 Ändrade till version 1.0 och la till användaranvändning i krav 52
2012-02-03 Ändrat lite i mottagare.vhd så att den nu kompilerar, får fixa till så vi kan simulera sen
    [mottagare.vhd]
2012-02-04 Lagt till så leden nollställs och så att vi inte fastnar i oändlig loop :), även lite grejer så vi inte hamnar i odefinerade ställen
2012-02-05 Saknas bara paritetsbit, fixas medelst 3 xnor och en not
    [sandare.vhd]
2012-02-05 Fixat paritetsbit (hoppas jag)
    [sandare.vhd]
2012-02-05 Fixat så reset är extern signal och så den nollställer utsignalen
    [sandare.vhd]
2012-02-05 Lagt till en fil som ska vara hela komponenten (lab.vhd) men vet inte hur man lättast integrerar de 2 komponenterna
2012-02-07 Gjort skelett till projektplan, rubriker måste ändras. Fixat med labbfiler och så också
    [lab.vhd, mottagare.vhd, sandare.vhd]
2012-02-07 Fixade till simuleringen, funkar nu
    [lab.vhd]
2012-02-13 Skrivit lite i systemskissen, är bara de enskilda enheterna som det ska skrivas om nu. La också till en egen LIPS.tex, då den förra hade fel kodning
2012-02-14 Lagt till text under Sensorenheten
2012-02-15 ndringar i sensorenheten, lagt till bild
2012-02-15 Såja, nu ska det fan inte läggas till fler filer somvi inte vill ha!
2012-03-01 Lagt till blockschema på regulatorn och mera text.
2012-03-01 Uppdaterat sensor.tex
2012-03-01 Mer sensortext
2012-03-02 Fixat bild på regulatorn och lagt till ett till specialkommando till styrenheten.
2012-03-08 Fixade rotationen på bilden och la den i bildmappen
2012-03-11 Skrivit p� sensor.tex
2012-03-11 ndrar sensor.tex och lade till lite text p� Sensor <-> komm
2012-03-14 Ändrat sensormodulens pinkonf
2012-03-20 Småfel i linjeskillnadsgrejen fixade
    [linjeskillnad.c]
2012-03-22 Lagt till sensor.c
2012-03-22 lagt till nya kodfiler f�r sensor ad
2012-03-22 Flyttat funktioner från sensor.c till sensor_ad.c
2012-03-23 laddar upp filerna f�r bussen. Vi kommer beh�va �ndra format p� dem, header filen �r tom f�r tillf�llet.
2012-03-26 lagt till styrenehten, den inneh�ller bara spi nu. Uppdaterat sensor lite.
2012-03-27 Början till en regulator, svårt att göra allt nu när jag inte har koll på hur styrningen fungerar
2012-03-27 Lagt till lite till regulatorn
2012-04-01 Fixat och donat, mest Tobbe som ändrat
    [avstandsskillnad.c, linjeskillnad.c, motor_test.c, motor_test.h, regulator.h, sensor.c]
2012-04-02 Fixat så att autonom reglering kan påbörjas
    [regulator.c]
2012-04-02 tog bort de gamla spi koderna, uppdaterat sensor och styrenhet
2012-04-16 lagt till s� tejp hittas i labyrint
2012-04-17 Koden hittar nu tejpmarkeringar och skiljer p� labyrintl�ge och linjel�ge.
2012-04-18 Roboten ska nu kunna se om den �r i labyrint eller i linje
2012-04-20 Fixat special och avstandsskillnad
    [avstandsskillnad.c, special.c, special.h]
2012-04-21 Lagt till kod f�r att utf�ra specialkommandon
2012-04-21 Fixat ny regulator
2012-04-21 Fixat lite med namn
    [regulator.c, regulator.h]
2012-04-21 Regleringen g�r skillnad p� linjer eller v�ggar
2012-04-23 Fixat lite med regulatorn
    [linjeskillnad.c, regulator.c, styr_specialkommando.c]
2012-04-24 Ny regulator, och nya sensorer
2012-04-26 Fixat lite med linjeregleringen
    [regulator.c]
2012-04-26 Fixat regulatorn och lite fjärrstyrning
    [linjeskillnad.c, regulator.c, regulator.h, sensor.c, sensor_ad.c, sensorvarde_omvandling.c, sensorvarde_omvandling.h]
2012-04-29 fixat rak styrning och höger/vänster sväng
    [motor_styrning.c, motor_styrning.h]
2012-04-29 Updaterat för 4 sensorer
2012-04-30 Bussen jobbar nu i cp/4 ist�llet f�r cp/16, alla enheter beh�ver programmeras om.
2012-05-01 Ny regulator
2012-05-01 Fixat lite på avståndsregulator
    [regulator.c]
2012-05-01 Fixat bättre med avståndsreglering
    [regulator.c]
2012-05-04 Ny kod som orsakade lite problem, ville inte skriva över
    [avstandsskillnad.c, bluetooth_interrupt.c]
2012-05-04 B�r g� att se r�tt info p� sk�rmen nu
2012-05-04 Rensat ut filer som inte anv�nds l�ngre samt uppdaterat all kod med dagens arbete.
2012-05-05 kalibrerat motorer
2012-05-06 aningen b�ttre regulator f�r labyrint.
2012-05-08 Ändrig lite i texfiler så de nästan går att kompilera
2012-05-08 sensor uppdatering och bild till linjesensorer
2012-05-08 UPPD. sensor
2012-05-09 Fixat styr och komm
    [komm_SPI.c, komm_init.c, komm_main.c, motor_styrning.c, motor_styrning.h, regulator.c, styr_main.c]
2012-05-09 Det mesta är nu fixat
    [sensor_ad.c, sensor_init.c, sensor_spi.c, sensor_spi.h, upptack_tejp.c]
2012-05-09 Uppdaterat sensor och styr med fler sensorer
2012-05-09 kommenterat motorstyrningen
2012-05-09 Sensor hårdvara
2012-05-09 kodfix motorstyrning klar
2012-05-09 fixat sensor_ad.c
2012-05-09 kodfix motorstyrning.h klar
2012-05-10 lagt in de sista knappkommandona samt lagt in tejpmarkeringsbilden
2012-05-10 pillat lite f�r att se om saker blir b�ttre
2012-05-10 Jobbar f�r att f� b�ttre specialkommandohantering.
2012-05-10 Fixat motorstyrningen i manuellt läge, tekdoc
2012-05-10 b�ttre kod f�r nya korsningshanteringen
2012-05-10 fixat koden till kortvänster sensorn
    [sensorvarde_omvandling.c]
2012-05-10 R�tt kod f�r nya specialkommandon
2012-05-10 optimerat koden i motorstyrning och linjeregulatorn
2012-05-10 pillat p� specialkommandon
